till-s/kicad-usbadc-a7m195xx/README.md

# 130MSPS Dual-Channel Scope - Hardware Design

Please visit the [super-repository](https://github.com/till-s/ScOpen) for more information about this project.
