till-s/kicad-usbadc-a7m195xx/hw/usbadc.kicad_pcb

## KiCad design hw/usbadc.kicad_pcb (2026-05-31)

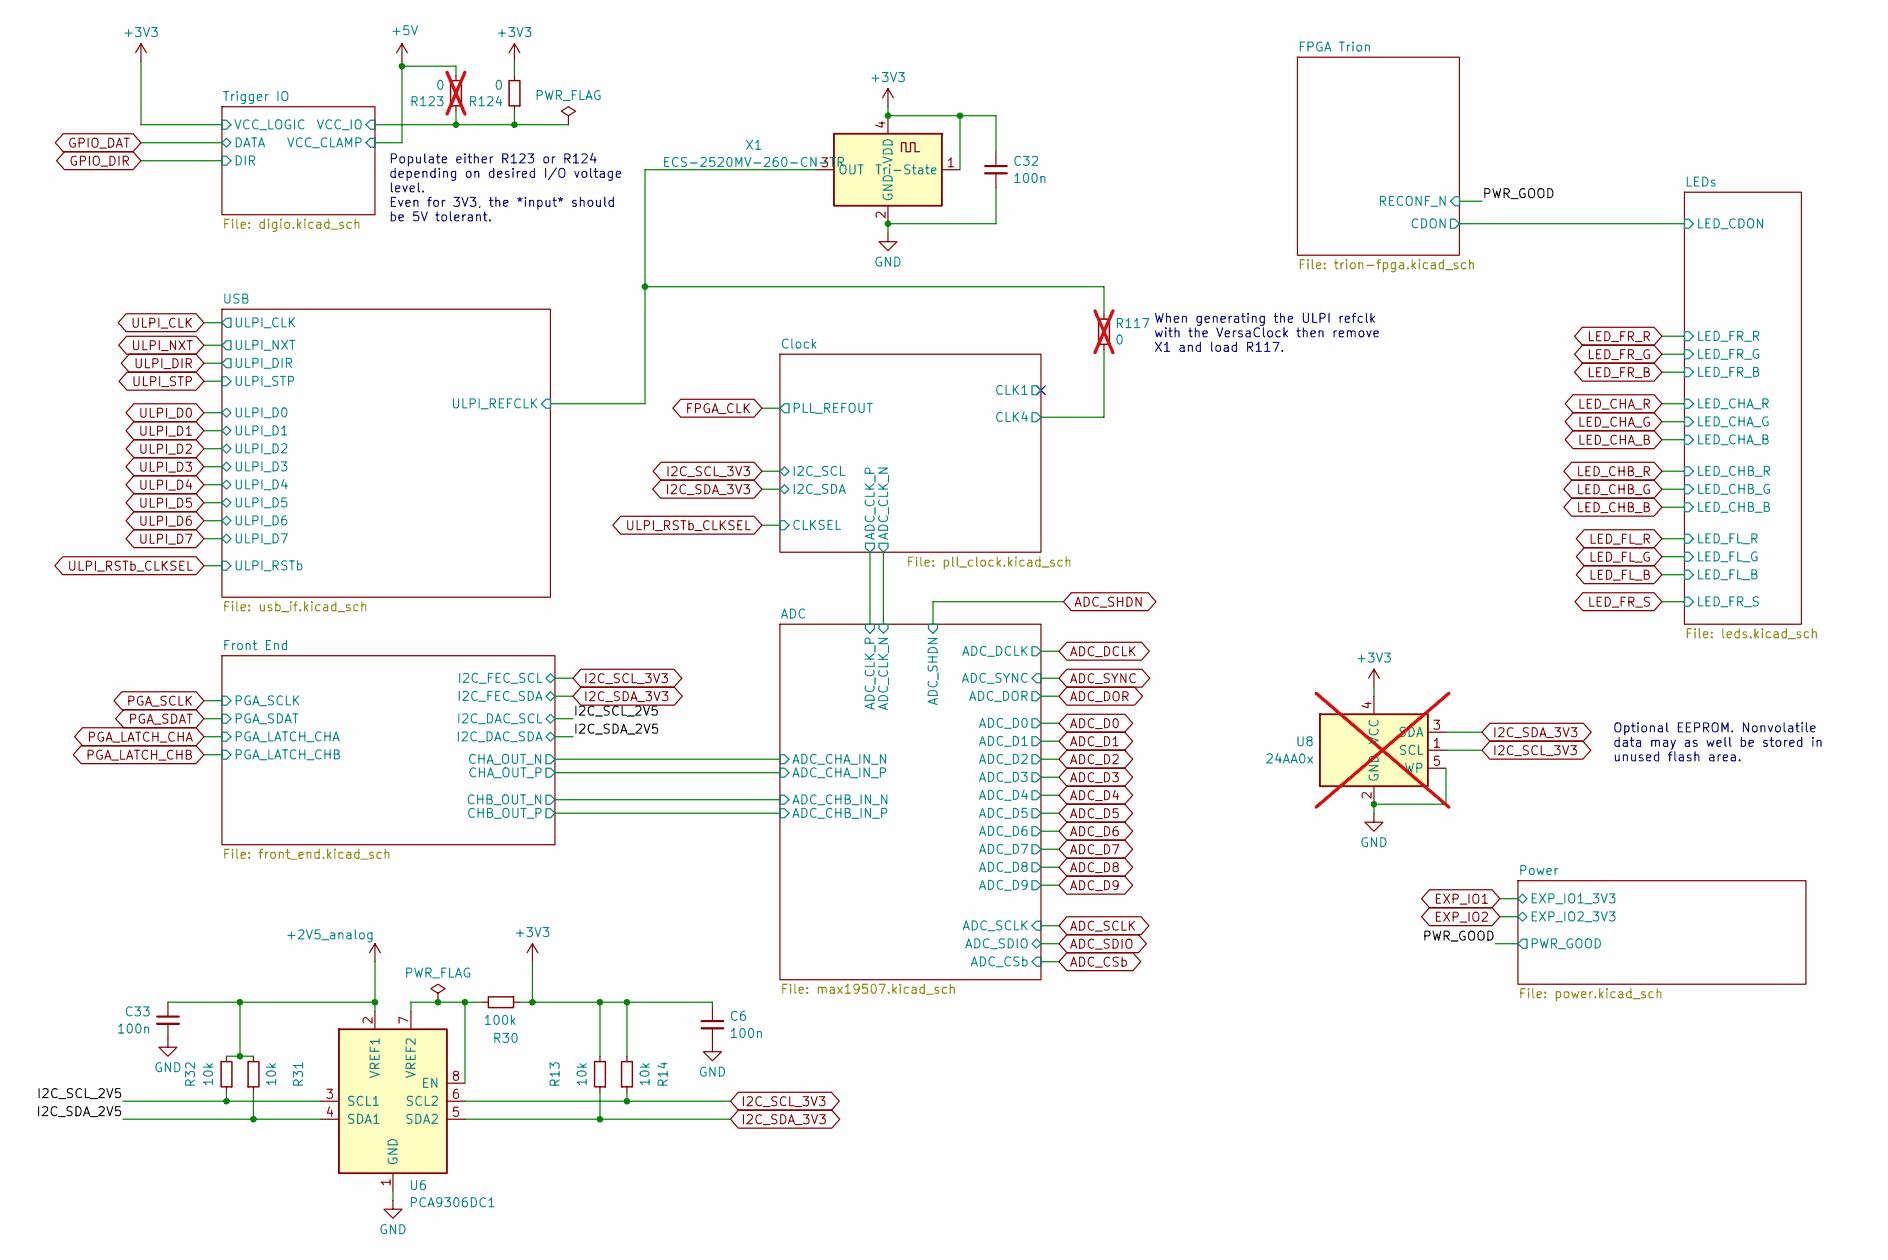
[picture p1: schematic usbadc.kicad_sch, 130MSPS Dual-Channel USB Scope]

Parts:
C6, C32, C33: 100n; C_0603_1608Metric; Part CL10B104KB8NFN
R13, R14, R31, R32: 10k; R_0603_1608Metric; Part RMCF0603FT10K0
R30: 100k; R_0603_1608Metric; Part RMCF0603FT100K
R117, R123: 0; R_0603_1608Metric; Part RMCF0603ZT0R00; not fitted
R124: 0; R_0603_1608Metric; Part RMCF0603ZT0R00
U6: PCA9306DC1; VSSOP-8_2.3x2mm_P0.5mm; Part PCA9306TDCURQ1
U8: 24AA0x; SOT-353_SC-70-5; Part 24AA01/LT; not fitted
X1: ECS-2520MV-260-CN-TR; Oscillator_SMD_ECS_2520MV-xxx-xx-4Pin_2.5x2.0mm; Part ECS-2520MV-260-CN-TR

Connections:
+2V5_analog: C33.1, R31.2, R32.2, U6.2 (VREF1); also elsewhere on the board
+3V3: C6.1, C32.1, R13.2, R14.2, R30.1, R124.2, U8.4 (VCC), X1.1 (Tri-State), X1.4 (VDD); also elsewhere on the board
+5V: R123.2; also elsewhere on the board
/Clock/CLK4: R117.2; also elsewhere on the board
/I2C_SCL_2V5: R32.1, U6.3 (SCL1); also elsewhere on the board
/I2C_SDA_2V5: R31.1, U6.4 (SDA1); also elsewhere on the board
/Trigger IO/VCC_IO: R123.1, R124.1; also elsewhere on the board
/USB/ULPI_REFCLK: R117.1, X1.3 (OUT); also elsewhere on the board
GND: C6.2, C32.2, C33.2, U6.1 (GND), U8.2 (GND), U8.5 (WP), X1.2 (GND); also elsewhere on the board
I2C_SCL_3V3: R14.1, U6.6 (SCL2), U8.1 (SCL); also elsewhere on the board
I2C_SDA_3V3: R13.1, U6.5 (SDA2), U8.3 (SDA); also elsewhere on the board
unnamed: R30.2, U6.7 (VREF2), U6.8 (EN)

Notes on the sheet:
Optional EEPROM. Nonvolatile data may as well be stored in unused flash area.
When generating the ULPI refclk with the VersaClock then remove X1 and load R117.
Populate either R123 or R124 depending on desired I/O voltage level. Even for 3V3, the *input* should be 5V tolerant.

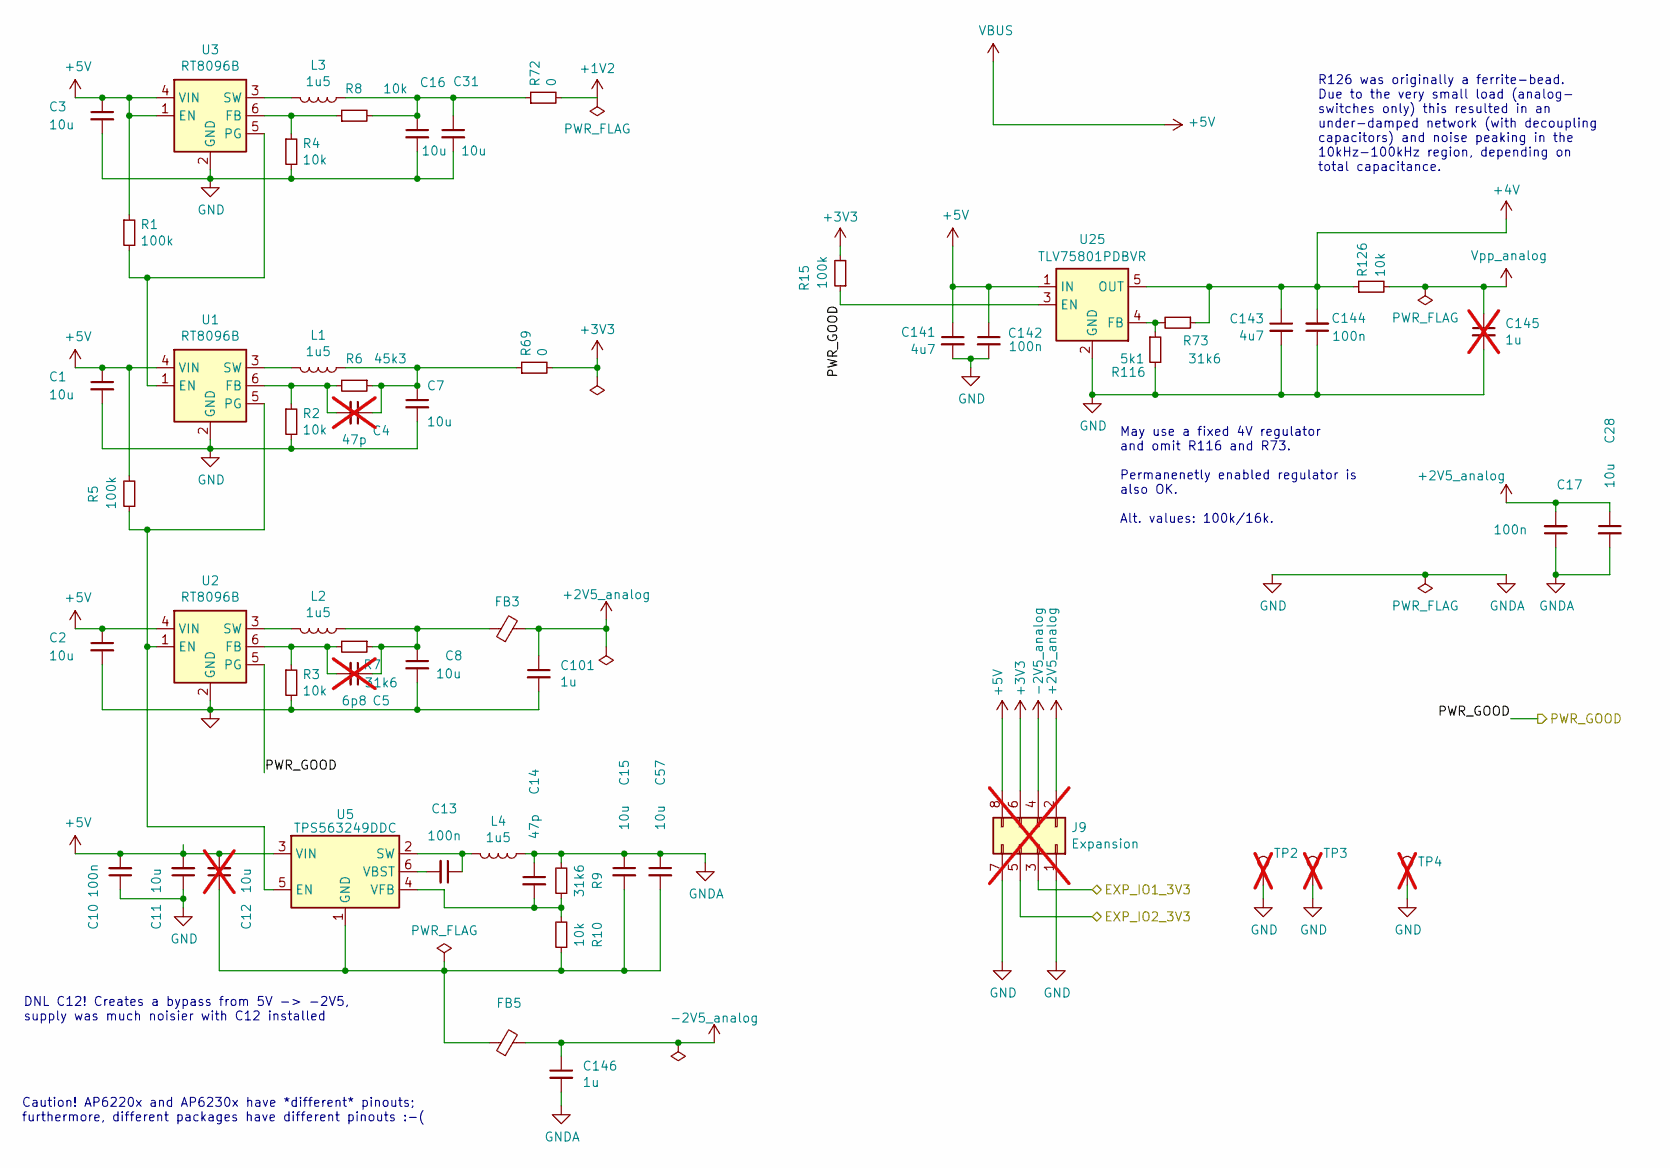
[picture p2: schematic power.kicad_sch, Power Supply and Expansion Connector]

Parts:
C1, C2, C3, C7, C8, C11, C15, C16, C28, C31, C57: 10u; C_1206_3216Metric; Part CL31A106KPHNNNE
C4: 47p; C_0603_1608Metric; Part 0603N470J101CT; not fitted
C5: 6p8; C_0603_1608Metric; Part 885012006050; not fitted
C10, C13, C17, C142, C144: 100n; C_0603_1608Metric; Part CL10B104KB8NFN
C12: 10u; C_1206_3216Metric; Part CL31A106KPHNNNE; not fitted
C14: 47p; C_0603_1608Metric; Part 0603N470J101CT
C101, C146: 1u; C_0805_2012Metric; Part CGA4J2X7R1C105K125AA
C141, C143: 4u7; C_0805_2012Metric; Part 2012X5R1C475K125AC
C145: 1u; C_0805_2012Metric; Part CGA4J2X7R1C105K125AA; not fitted
FB3, FB5: 600Ohm@100MHz; L_0603_1608Metric; Part MI0603J601R-10
J9: Expansion; PinHeader_2x04_P2.54mm_Vertical; not fitted
L1, L2, L3, L4: 1u5; L_1008_2520Metric; Part BDCD002520121R5MS1
R1, R5, R15: 100k; R_0603_1608Metric; Part RMCF0603FT100K
R2, R3, R4, R8, R10, R126: 10k; R_0603_1608Metric; Part RMCF0603FT10K0
R6: 45k3; R_0603_1608Metric; Part RMCF0603FT45K3
R7, R9, R73: 31k6; R_0603_1608Metric; Part RMCF0603FT31K6
R69, R72: 0; R_0603_1608Metric; Part RMCF0603ZT0R00
R116: 5k1; R_0603_1608Metric; Part RMCF0603FT5K10
TP2, TP3, TP4: TestPoint; PinHeader_1x01_P2.54mm_Vertical; not fitted
U1, U2, U3: RT8096B; SOT-23-6; Part RT8096BHGE
U5: TPS563249DDC; SOT-23-6; Part TPS563249DDCR
U25: TLV75801PDBVR; SOT-23-5; Part TLV75801PDBVR

Connections:
+1V2: R72.2; also elsewhere on the board
+2V5_analog: C17.2, C28.1, C101.1, FB3.2, J9.2; also elsewhere on the board
+3V3: J9.6, R15.2, R69.2; also elsewhere on the board
+4V: C143.1, C144.2, R73.1, R126.1, U25.5 (OUT); also elsewhere on the board
+5V: C1.1, C2.1, C3.1, C10.2, C11.2, C12.2, C141.1, C142.1, J9.8, R1.1, R5.2, U1.4 (VIN), U2.4 (VIN), U3.1 (EN), U3.4 (VIN), U5.3 (VIN), U25.1 (IN); also elsewhere on the board
-2V5_analog: C146.1, FB5.2, J9.4; also elsewhere on the board
/PWR_GOOD: R15.1, U2.5 (PG), U25.3 (EN); also elsewhere on the board
EXP_IO1: J9.3; also elsewhere on the board
EXP_IO2: J9.5; also elsewhere on the board
GND: C1.2, C2.2, C3.2, C7.2, C8.2, C10.1, C11.1, C14.1, C15.1, C16.2, C17.1, C28.2, C31.2, C57.1, C101.2, C141.2, C142.2, C143.2, C144.1, C145.2, C146.2, J9.1, J9.7, L4.1, R2.2, R3.2, R4.2, R9.2, R116.2, TP2.1, TP3.1, TP4.1, U1.2 (GND), U2.2 (GND), U3.2 (GND), U25.2 (GND); also elsewhere on the board
unnamed: C4.1, C7.1, L1.1, R6.1, R69.1
unnamed: C5.1, C8.1, FB3.1, L2.1, R7.1
unnamed: C16.1, C31.1, L3.1, R8.2, R72.1
unnamed: R1.2, U1.1 (EN), U3.5 (PG)
unnamed: C4.2, R2.1, R6.2, U1.6 (FB)
unnamed: R5.1, U1.5 (PG), U2.1 (EN), U5.5 (EN)
unnamed: L1.2, U1.3 (SW)
unnamed: C5.2, R3.1, R7.2, U2.6 (FB)
unnamed: L2.2, U2.3 (SW)
unnamed: R4.1, R8.1, U3.6 (FB)
unnamed: L3.2, U3.3 (SW)
unnamed: C12.1, C15.2, C57.2, FB5.1, R10.1, U5.1 (GND)
unnamed: C13.1, L4.2, U5.2 (SW)
unnamed: C13.2, U5.6 (VBST)
unnamed: C14.2, R9.1, R10.2, U5.4 (VFB)
unnamed: R73.2, R116.1, U25.4 (FB)
Vpp_analog: C145.1, R126.2; also elsewhere on the board

Notes on the sheet:
May use a fixed 4V regulator and omit R116 and R73. Permanenetly enabled regulator is also OK. Alt. values: 100k/16k.
R126 was originally a ferrite-bead. Due to the very small load (analog- switches only) this resulted in an under-damped network (with decoupling capacitors) and noise peaking in the 10kHz-100kHz region, depending on total capacitance.
DNL C12! Creates a bypass from 5V -> -2V5, supply was much noisier with C12 installed
Caution! AP6220x and AP6230x have *different* pinouts; furthermore, different packages have different pinouts :-(

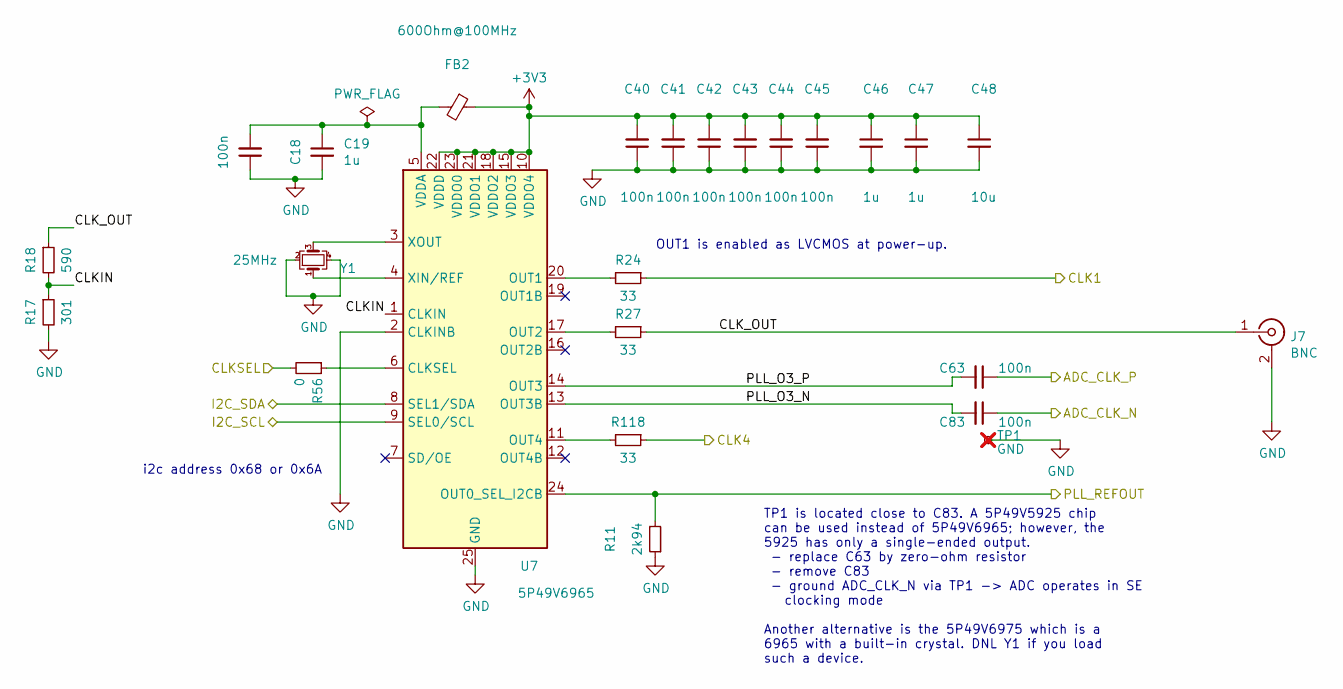
[picture p3: schematic pll_clock.kicad_sch, Clock Generator]

Parts:
C18, C40, C41, C42, C43, C44, C45, C63, C83: 100n; C_0603_1608Metric; Part CL10B104KB8NFN
C19, C46, C47: 1u; C_0805_2012Metric; Part CGA4J2X7R1C105K125AA
C48: 10u; C_1206_3216Metric; Part CL31A106KPHNNNE
FB2: 600Ohm@100MHz; L_0603_1608Metric; Part MI0603J601R-10
J7: BNC; BNC_Molex_0731713150; Part 0731713150
R11: 2k94; R_0603_1608Metric; Part RMCF0603FT2K94
R17: 301; R_0603_1608Metric; Part RMCF0603FT301R
R18: 590; R_0603_1608Metric; Part RMCF0603FT590R
R24, R27, R118: 33; R_0603_1608Metric; Part RMCF0603FT33R0
R56: 0; R_0603_1608Metric; Part RMCF0603ZT0R00
TP1: GND; single_pad; not fitted
U7: 5P49V6965; QFN-24-1EP_4x4mm_P0.5mm_EP2.8x2.8mm; Part 5P49V6965A000NLGI8
Y1: 25MHz; Crystal_SMD_Abracon_ABM10-4Pin_2.5x2.0mm; Part ABM10W-25.0000MHZ-8-B1U-T3

Connections:
+3V3: C40.2, C41.2, C42.2, C43.2, C44.2, C45.2, C46.1, C47.1, C48.1, FB2.1, U7.10 (VDDO4), U7.15 (VDDO3), U7.18 (VDDO2), U7.21 (VDDO1), U7.22 (VDDD), U7.23 (VDDO0); also elsewhere on the board
/ADC/ADC_CLK_N: C83.1; also elsewhere on the board
/ADC/ADC_CLK_P: C63.1; also elsewhere on the board
/Clock/CLK1: R24.1
/Clock/CLK4: R118.1; also elsewhere on the board
/Clock/CLKIN: R17.1, R18.2, U7.1 (CLKIN)
/Clock/CLK_OUT: J7.1 (In), R18.1, R27.1
/Clock/PLL_O3_N: C83.2, U7.13 (OUT3B)
/Clock/PLL_O3_P: C63.2, U7.14 (OUT3)
FPGA_CLK: R11.2, U7.24 (OUT0_SEL_I2CB); also elsewhere on the board
GND: C18.1, C19.2, C40.1, C41.1, C42.1, C43.1, C44.1, C45.1, C46.2, C47.2, C48.2, J7.2 (Ext), R11.1, R17.2, TP1.1, U7.2 (CLKINB), U7.25 (GND), Y1.2, Y1.4; also elsewhere on the board
I2C_SCL_3V3: U7.9 (SEL0/SCL); also elsewhere on the board
I2C_SDA_3V3: U7.8 (SEL1/SDA); also elsewhere on the board
unnamed: R56.1, U7.6 (CLKSEL)
unnamed: R24.2, U7.20 (OUT1)
unnamed: R27.2, U7.17 (OUT2)
unnamed: R118.2, U7.11 (OUT4)
unnamed: C18.2, C19.1, FB2.2, U7.5 (VDDA)
unnamed: U7.4 (XIN/REF), Y1.1
unnamed: U7.3 (XOUT), Y1.3
ULPI_RSTb_CLKSEL: R56.2; also elsewhere on the board

Notes on the sheet:
TP1 is located close to C83. A 5P49V5925 chip can be used instead of 5P49V6965; however, the 5925 has only a single-ended output. - replace C63 by zero-ohm resistor - remove C83 - ground ADC_CLK_N via TP1 -> ADC operates in SE clocking mode Another alternative is the 5P49V6975 which is a 6965 with 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
i2c address 0x68 or 0x6A
OUT1 is enabled as LVCMOS at power-up.

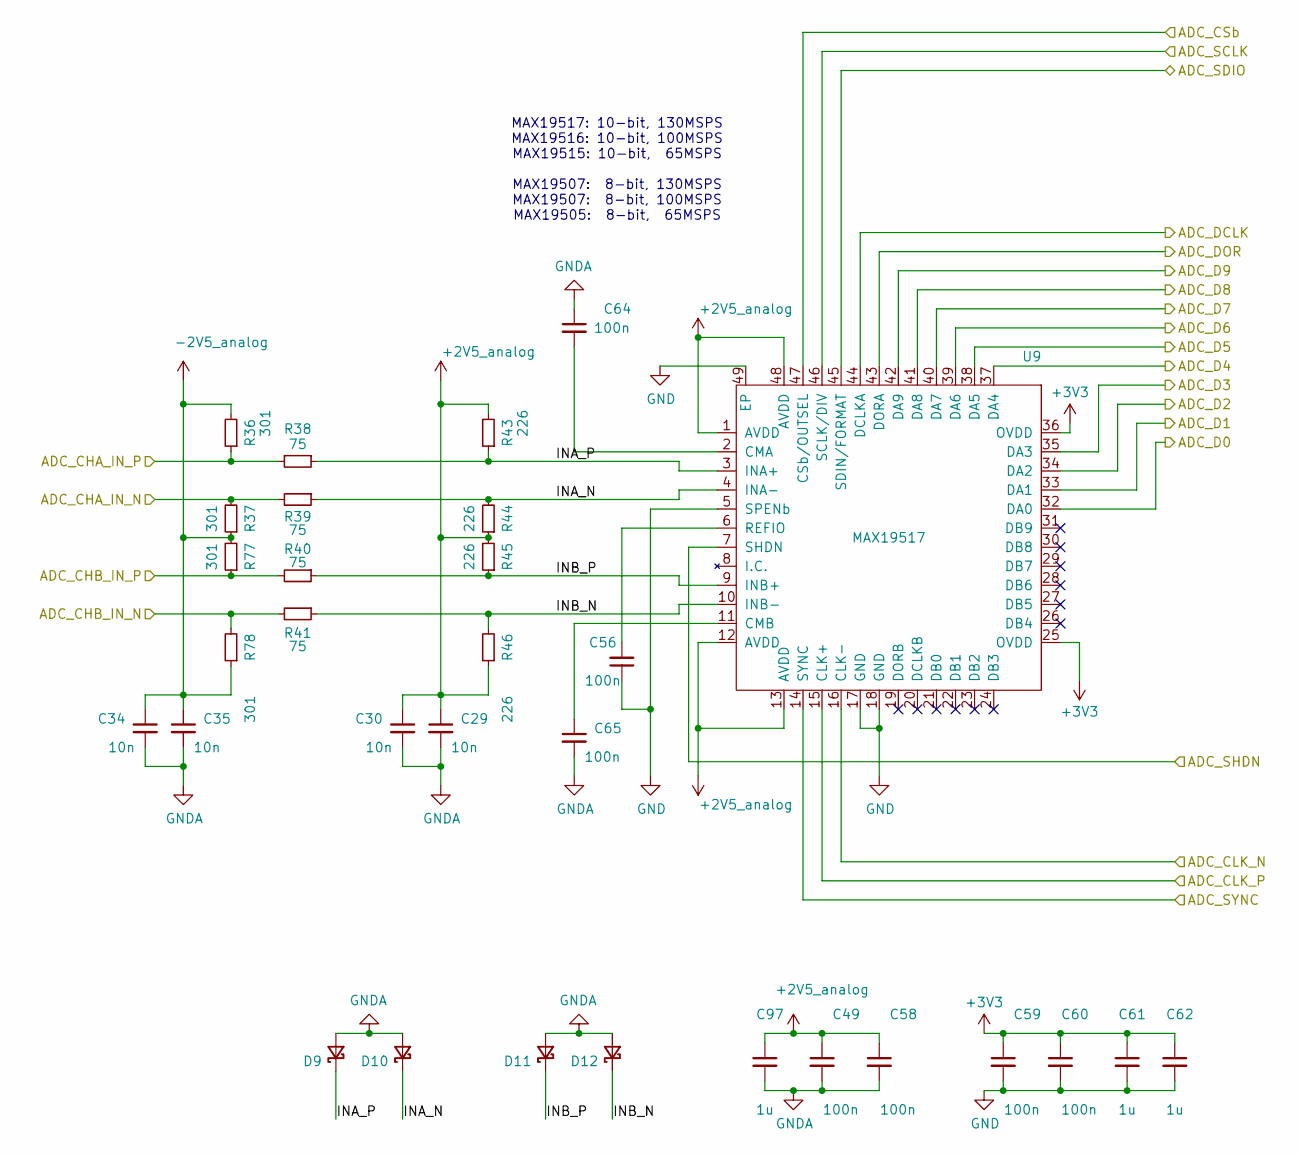
[picture p4: schematic max19507.kicad_sch, Dual-Channel ADC]

Parts:
C29, C30, C34, C35: 10n; C_0603_1608Metric; Part C0603C103J5RACTU
C49, C58, C59, C60: 100n; C_0402_1005Metric; Part C1005X7R1E104K050BB
C56, C64, C65: 100n; C_0603_1608Metric; Part CL10B104KB8NFN
C61, C62, C97: 1u; C_0805_2012Metric; Part CGA4J2X7R1C105K125AA
D9, D10, D11, D12: NSR0170HT1G; D_SOD-323; Part NSR0170HT1G
R36, R37, R77, R78: 301; R_0603_1608Metric; Part RMCF0603FT301R
R38, R39, R40, R41: 75; R_0603_1608Metric; Part RMCF0603FT75R0
R43, R44, R45, R46: 226; R_0603_1608Metric; Part RMCF0603FT226R
U9: MAX19517; QFN-48-1EP_7x7mm_P0.5mm_EP5.6x5.6mm_ThermalVias_biggerholes; Part MAX19517ETM+

Connections:
+2V5_analog: C29.1, C30.1, C49.1, C58.1, C97.1, R43.2, R44.1, R45.2, R46.1, U9.1 (AVDD), U9.12 (AVDD), U9.13 (AVDD), U9.48 (AVDD); also elsewhere on the board
+3V3: C59.1, C60.1, C61.1, C62.1, U9.25 (OVDD), U9.36 (OVDD); also elsewhere on the board
-2V5_analog: C34.1, C35.1, R36.2, R37.1, R77.2, R78.1; also elsewhere on the board
/ADC/ADC_CHA_IN_N: R37.2, R39.2; also elsewhere on the board
/ADC/ADC_CHA_IN_P: R36.1, R38.2; also elsewhere on the board
/ADC/ADC_CHB_IN_N: R41.2, R78.2; also elsewhere on the board
/ADC/ADC_CHB_IN_P: R40.2, R77.1; also elsewhere on the board
/ADC/ADC_CLK_N: U9.16 (CLK-); also elsewhere on the board
/ADC/ADC_CLK_P: U9.15 (CLK+); also elsewhere on the board
/ADC/INA_N: D10.1 (K), R39.1, R44.2, U9.4 (INA-)
/ADC/INA_P: D9.1 (K), R38.1, R43.1, U9.3 (INA+)
/ADC/INB_N: D12.1 (K), R41.1, R46.2, U9.10 (INB-)
/ADC/INB_P: D11.1 (K), R40.1, R45.1, U9.9 (INB+)
ADC_CSb: U9.47 (CSb/OUTSEL); also elsewhere on the board
ADC_D0: U9.32 (DA0); also elsewhere on the board
ADC_D1: U9.33 (DA1); also elsewhere on the board
ADC_D2: U9.34 (DA2); also elsewhere on the board
ADC_D3: U9.35 (DA3); also elsewhere on the board
ADC_D4: U9.37 (DA4); also elsewhere on the board
ADC_D5: U9.38 (DA5); also elsewhere on the board
ADC_D6: U9.39 (DA6); also elsewhere on the board
ADC_D7: U9.40 (DA7); also elsewhere on the board
ADC_D8: U9.41 (DA8); also elsewhere on the board
ADC_D9: U9.42 (DA9); also elsewhere on the board
ADC_DCLK: U9.44 (DCLKA); also elsewhere on the board
ADC_DOR: U9.43 (DORA); also elsewhere on the board
ADC_SCLK: U9.46 (SCLK/DIV); also elsewhere on the board
ADC_SDIO: U9.45 (SDIN/FORMAT); also elsewhere on the board
ADC_SHDN: U9.7 (SHDN); also elsewhere on the board
ADC_SYNC: U9.14 (SYNC); also elsewhere on the board
GND: C29.2, C30.2, C34.2, C35.2, C49.2, C56.1, C58.2, C59.2, C60.2, C61.2, C62.2, C64.1, C65.2, C97.2, D9.2 (A), D10.2 (A), D11.2 (A), D12.2 (A), U9.5 (SPENb), U9.17 (GND), U9.18 (GND), U9.49 (EP); also elsewhere on the board
unnamed: C64.2, U9.2 (CMA)
unnamed: C65.1, U9.11 (CMB)
unnamed: C56.2, U9.6 (REFIO)

Notes on the sheet:
MAX19517: 10-bit, 130MSPS MAX19516: 10-bit, 100MSPS MAX19515: 10-bit, 65MSPS MAX19507: 8-bit, 130MSPS MAX19507: 8-bit, 100MSPS MAX19505: 8-bit, 65MSPS

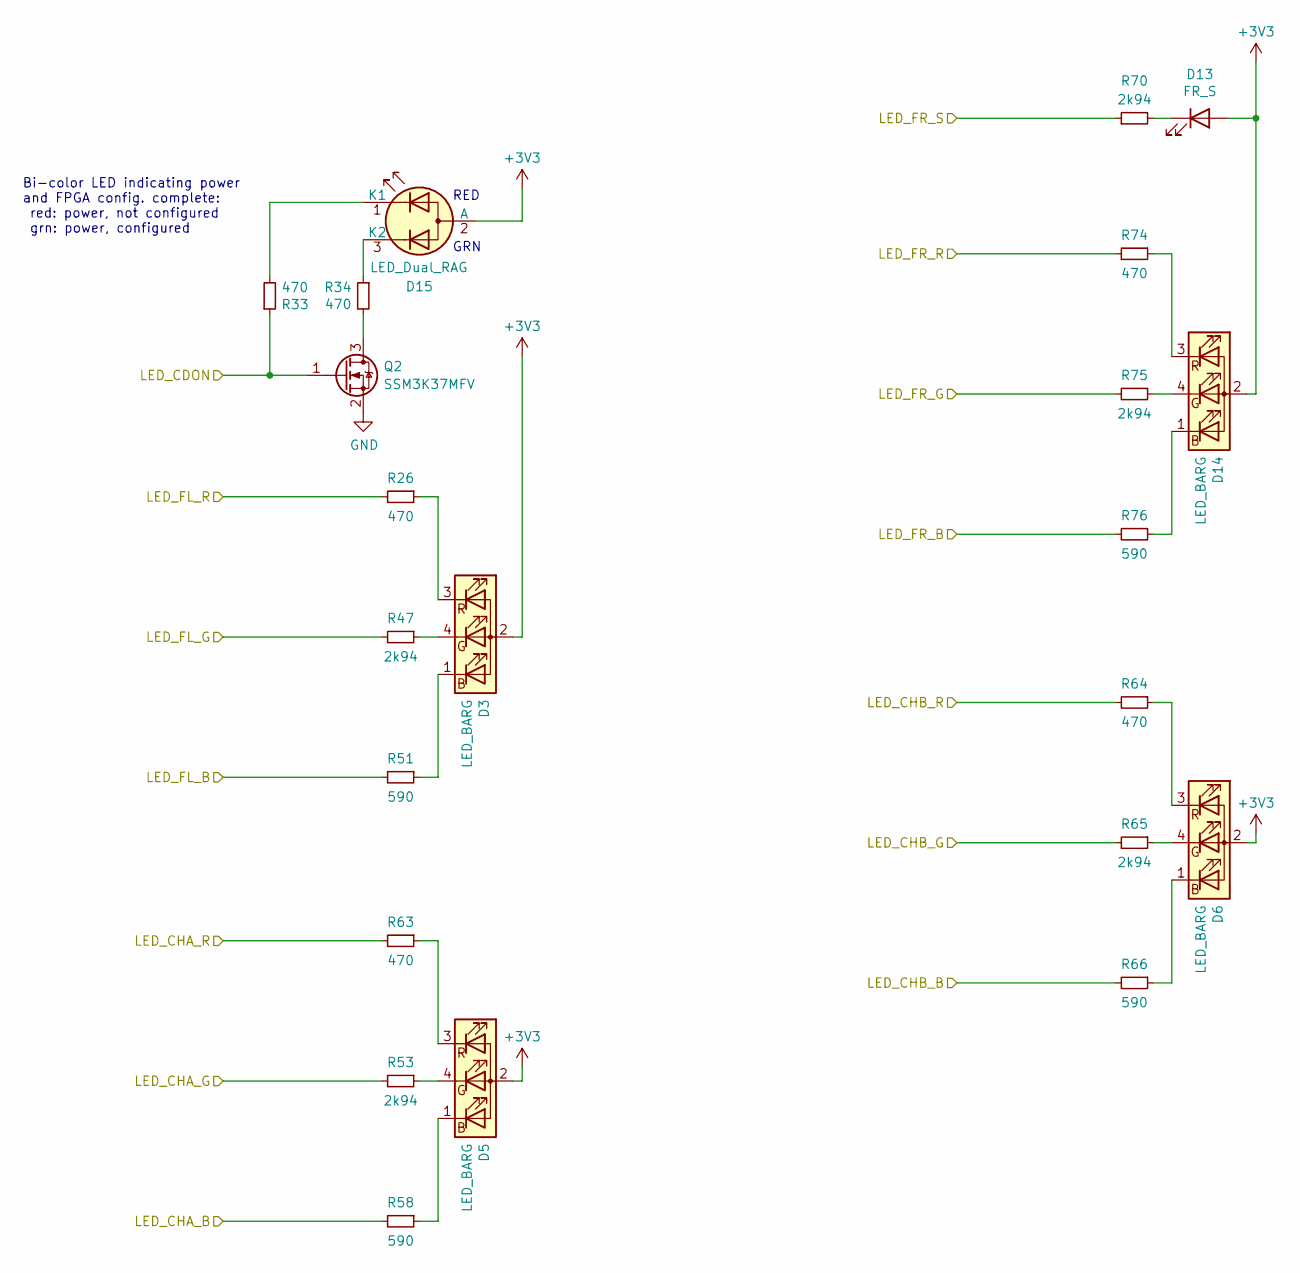
[picture p5: schematic leds.kicad_sch]

Parts:
D3, D5, D6, D14: LED_BARG; LED_RGB_2504_horiz_barg; Part APFA2507QBDSEEZGKC
D13: FR_S; LED_0603_1608Metric_reduced_cyrd; Part 155060GS75300
D15: LED_Dual_RAG; LED_Wuerth_Sideview; Part 155124RV73200
Q2: SSM3K37MFV; SOT-723; Part SSM3K37MFV
R26, R33, R34, R63, R64, R74: 470; R_0603_1608Metric; Part RMCF0603FT470R
R47, R53, R65, R75: 2k94; R_0603_1608Metric; Part RMCF0603FT2K94
R51, R58, R66, R76: 590; R_0603_1608Metric; Part RMCF0603FT590R
R70: 2k94; R_0603_1608Metric; Part RMCF0603FT470R

Connections:
+3V3: D3.2 (A), D5.2 (A), D6.2 (A), D13.2 (A), D14.2 (A), D15.2 (A); also elsewhere on the board
/FPGA Trion/CDON: Q2.1 (G), R33.1; also elsewhere on the board
GND: Q2.2 (S); also elsewhere on the board
LED_CHA_B: R58.2; also elsewhere on the board
LED_CHA_G: R53.2; also elsewhere on the board
LED_CHA_R: R63.2; also elsewhere on the board
LED_CHB_B: R66.2; also elsewhere on the board
LED_CHB_G: R65.2; also elsewhere on the board
LED_CHB_R: R64.2; also elsewhere on the board
LED_FL_B: R51.2; also elsewhere on the board
LED_FL_G: R47.2; also elsewhere on the board
LED_FL_R: R26.2; also elsewhere on the board
LED_FR_B: R76.2; also elsewhere on the board
LED_FR_G: R75.2; also elsewhere on the board
LED_FR_R: R74.2; also elsewhere on the board
LED_FR_S: R70.1; also elsewhere on the board
unnamed: D3.1 (BK), R51.1
unnamed: D3.4 (GK), R47.1
unnamed: D3.3 (RK), R26.1
unnamed: D5.1 (BK), R58.1
unnamed: D5.4 (GK), R53.1
unnamed: D5.3 (RK), R63.1
unnamed: D6.1 (BK), R66.1
unnamed: D6.4 (GK), R65.1
unnamed: D6.3 (RK), R64.1
unnamed: D13.1 (K), R70.2
unnamed: D14.1 (BK), R76.1
unnamed: D14.4 (GK), R75.1
unnamed: D14.3 (RK), R74.1
unnamed: D15.1 (K1), R33.2
unnamed: D15.3 (K2), R34.1
unnamed: Q2.3 (D), R34.2

Notes on the sheet:
RED
GRN
Bi-color LED indicating power and FPGA config. complete: red: power, not configured grn: power, configured

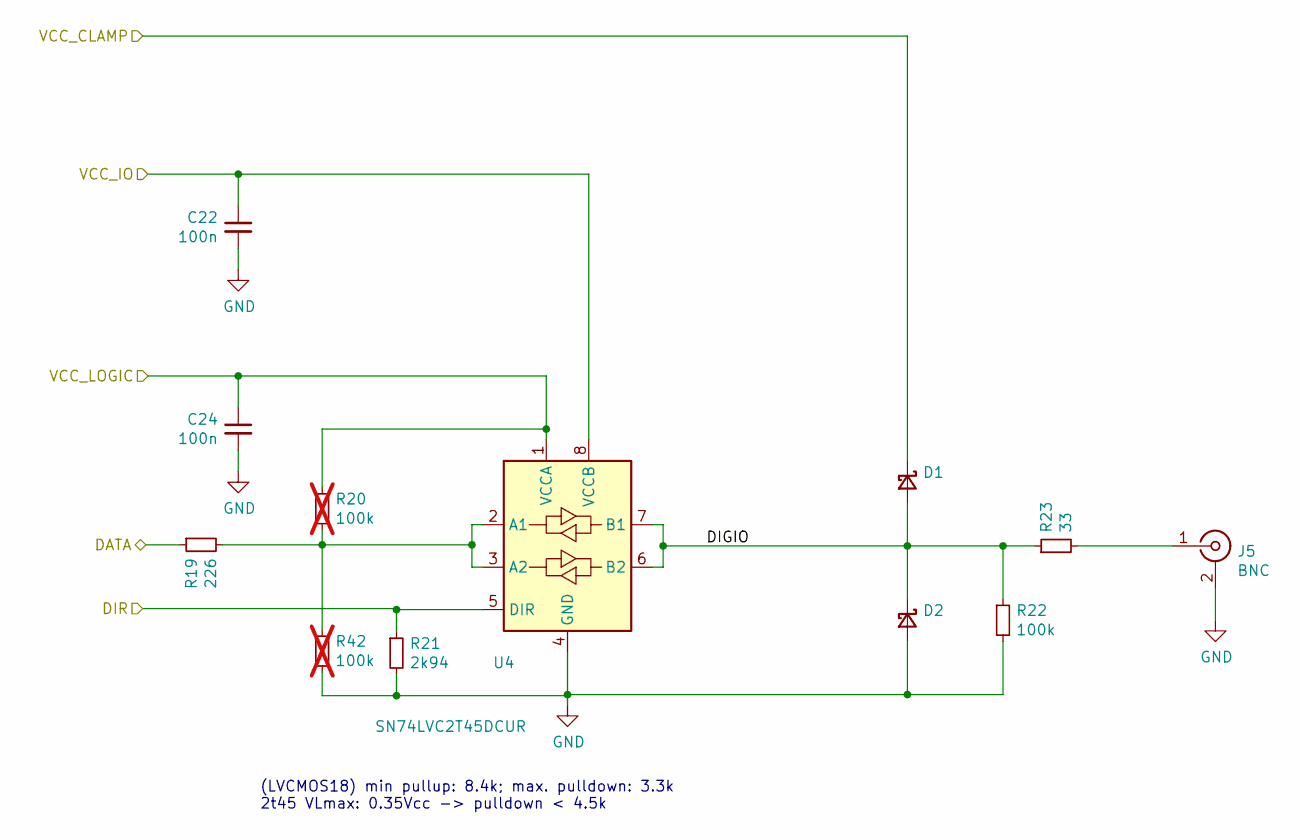
[picture p6: schematic digio.kicad_sch, GPIO (External Trigger In/Out)]

Parts:
C22, C24: 100n; C_0603_1608Metric; Part CL10B104KB8NFN
D1, D2: NSR0170HT1G; D_SOD-323; Part NSR0170HT1G
J5: BNC; BNC_Molex_0731713150; Part 0731713150
R19: 226; R_0603_1608Metric; Part RMCF0603FT226R
R20, R42: 100k; R_0603_1608Metric; Part RMCF0603FT100K; not fitted
R21: 2k94; R_0603_1608Metric; Part RMCF0603FT2K94
R22: 100k; R_0603_1608Metric; Part RMCF0603FT100K
R23: 33; R_0603_1608Metric; Part RMCF0603FT33R0
U4: SN74LVC2T45DCUR; VSSOP-8_2.3x2mm_P0.5mm; Part 74LVC2T45DC,125

Connections:
+3V3: C24.1, R20.1, U4.1 (VCCA); also elsewhere on the board
+5V: D1.1 (K); also elsewhere on the board
/Trigger IO/DIGIO: D1.2 (A), D2.1 (K), R22.1, R23.1, U4.6 (B2), U4.7 (B1)
/Trigger IO/VCC_IO: C22.1, U4.8 (VCCB); also elsewhere on the board
GND: C22.2, C24.2, D2.2 (A), J5.2 (Ext), R21.2, R22.2, R42.2, U4.4 (GND); also elsewhere on the board
GPIO_DAT: R19.1; also elsewhere on the board
GPIO_DIR: R21.1, U4.5 (DIR); also elsewhere on the board
unnamed: J5.1 (In), R23.2
unnamed: R19.2, R20.2, R42.1, U4.2 (A1), U4.3 (A2)

Notes on the sheet:
(LVCMOS18) min pullup: 8.4k; max. pulldown: 3.3k 2t45 VLmax: 0.35Vcc -> pulldown < 4.5k

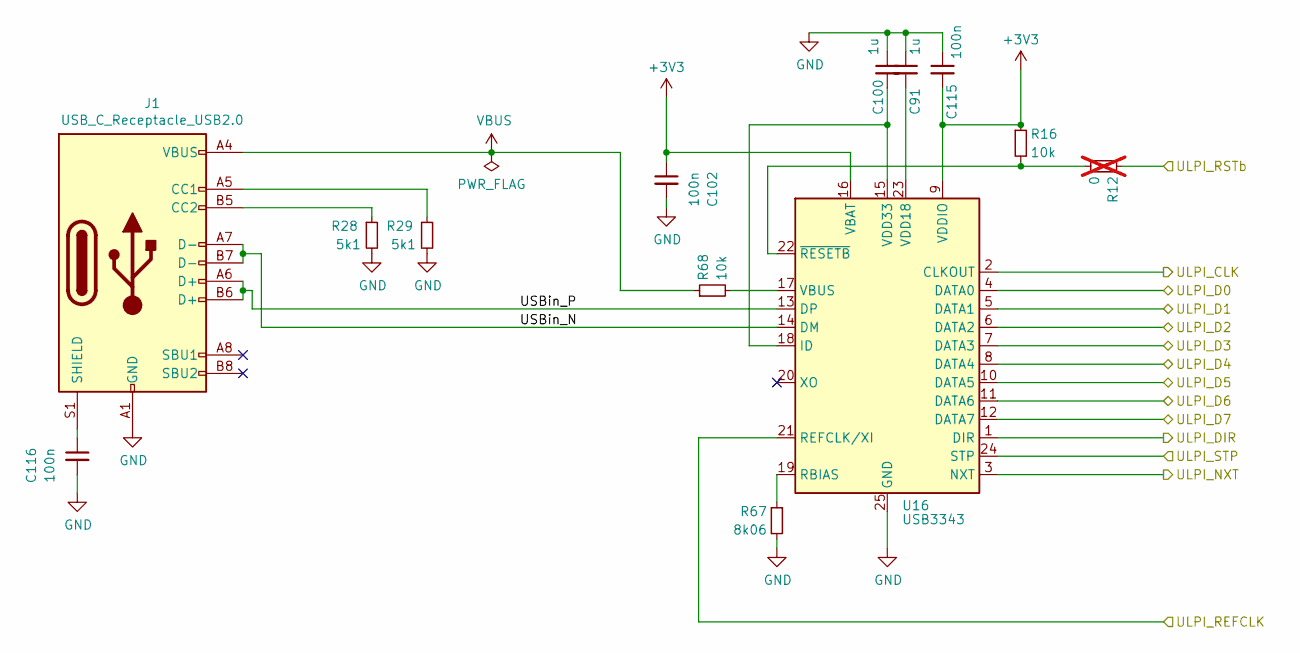
[picture p7: schematic usb_if.kicad_sch, USB Phy]

Parts:
C91, C100: 1u; C_0603_1608Metric; Part CL10B104KB8NFNC
C102, C115, C116: 100n; C_0603_1608Metric; Part CL10B104KB8NFN
J1: USB_C_Receptacle_USB2.0; USB_C_Receptacle_Molex_2171790001_16P_TopMnt_Horizontal; Part 2171790001
R12: 0; R_0603_1608Metric; Part RMCF0603ZT0R00; not fitted
R16, R68: 10k; R_0603_1608Metric; Part RMCF0603FT10K0
R28, R29: 5k1; R_0603_1608Metric; Part RMCF0603FT5K10
R67: 8k06; R_0603_1608Metric; Part RMCF0603FT8K06
U16: USB3343; QFN-24-1EP_4x4mm_P0.5mm_EP2.6x2.6mm; Part USB3343-CP-TR

Connections:
+3V3: C102.1, C115.2, R16.1, U16.9 (VDDIO), U16.16 (VBAT); also elsewhere on the board
+5V: J1.A4 (VBUS), J1.A9 (VBUS), J1.B4 (VBUS), J1.B9 (VBUS), R68.1; also elsewhere on the board
/USB/ULPI_REFCLK: U16.21 (REFCLK/XI); also elsewhere on the board
/USB/USBin_N: J1.A7 (D-), J1.B7 (D-), U16.14 (DM)
/USB/USBin_P: J1.A6 (D+), J1.B6 (D+), U16.13 (DP)
GND: C91.1, C100.1, C102.2, C115.1, C116.2, J1.A1 (GND), J1.A12 (GND), J1.B1 (GND), J1.B12 (GND), R28.2, R29.2, R67.2, U16.25 (GND); also elsewhere on the board
unnamed: J1.A5 (CC1), R29.1
unnamed: J1.B5 (CC2), R28.1
unnamed: C116.1, J1.S1 (SHIELD)
unnamed: C100.2, U16.15 (VDD33), U16.18 (ID)
unnamed: R67.1, U16.19 (RBIAS)
unnamed: R68.2, U16.17 (VBUS)
unnamed: C91.2, U16.23 (VDD18)
unnamed: R12.2, R16.2, U16.22 (~RESETB)
ULPI_CLK: U16.2 (CLKOUT); also elsewhere on the board
ULPI_D0: U16.4 (DATA0); also elsewhere on the board
ULPI_D1: U16.5 (DATA1); also elsewhere on the board
ULPI_D2: U16.6 (DATA2); also elsewhere on the board
ULPI_D3: U16.7 (DATA3); also elsewhere on the board
ULPI_D4: U16.8 (DATA4); also elsewhere on the board
ULPI_D5: U16.10 (DATA5); also elsewhere on the board
ULPI_D6: U16.11 (DATA6); also elsewhere on the board
ULPI_D7: U16.12 (DATA7); also elsewhere on the board
ULPI_DIR: U16.1 (DIR); also elsewhere on the board
ULPI_NXT: U16.3 (NXT); also elsewhere on the board
ULPI_RSTb_CLKSEL: R12.1; also elsewhere on the board
ULPI_STP: U16.24 (STP); also elsewhere on the board

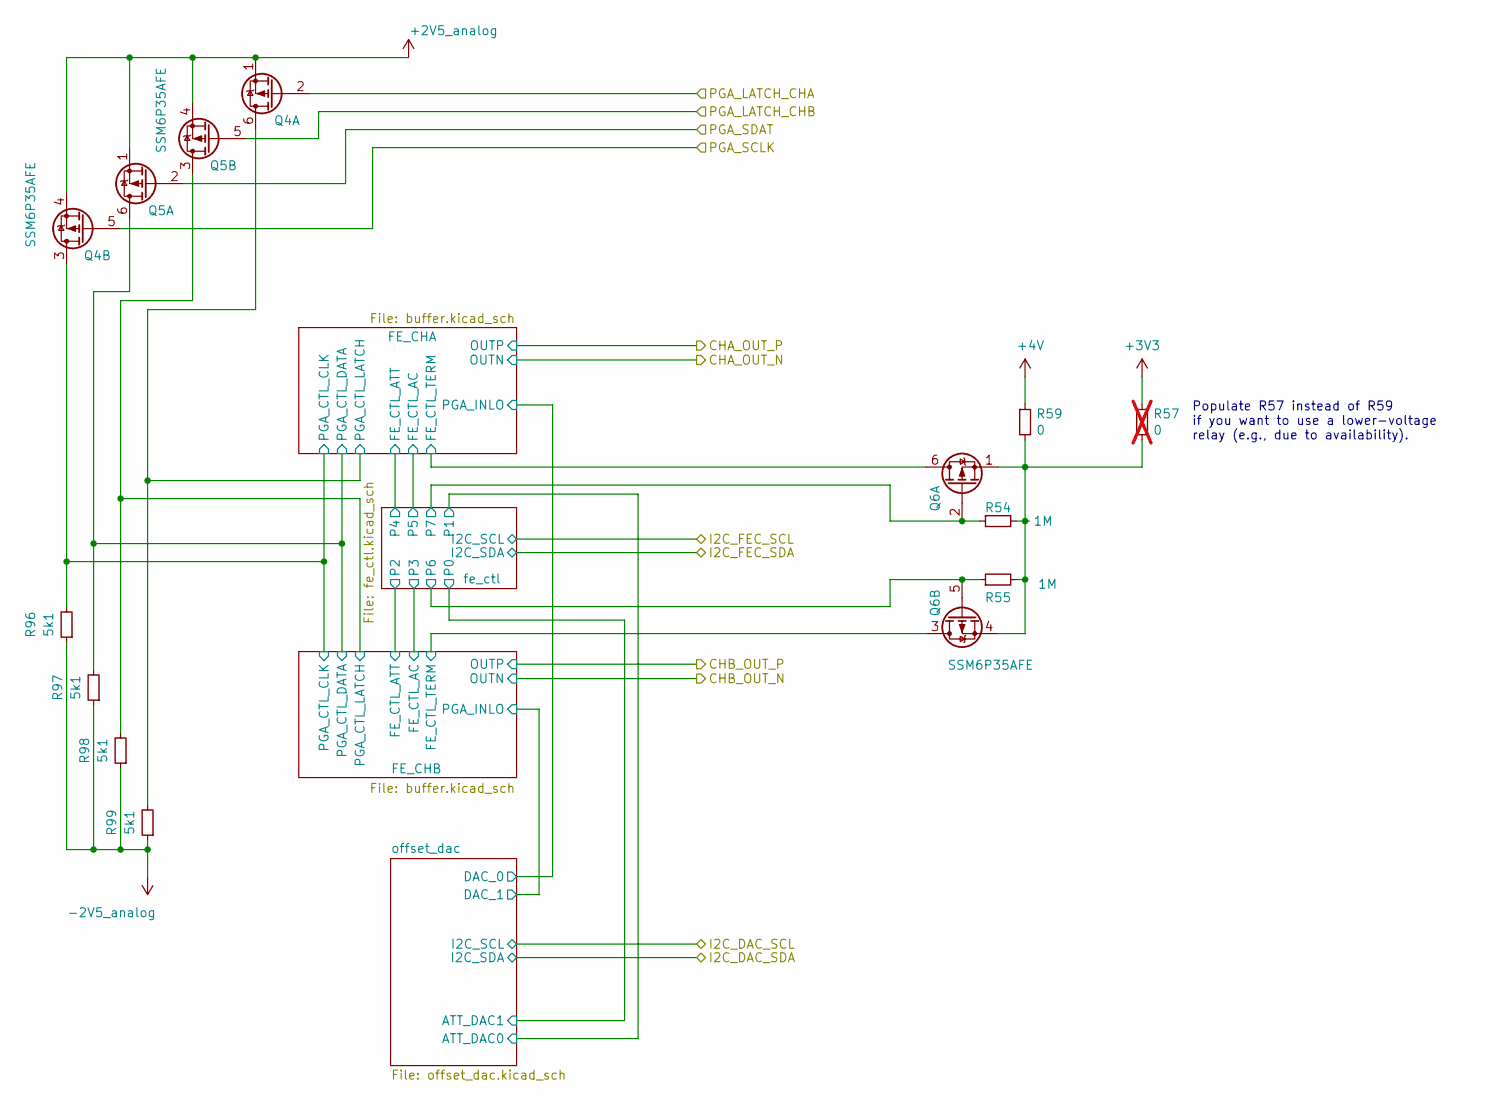
[picture p8: schematic front_end.kicad_sch, Front End]

Parts:
Q4, Q5, Q6: SSM6P35AFE; SOT-563-adjusted; Part SSM6P35AFE
R54, R55: 1M; R_0603_1608Metric; Part RMCF0603FT1M00
R57: 0; R_0603_1608Metric; Part RMCF0603ZT0R00; not fitted
R59: 0; R_0603_1608Metric; Part RMCF0603ZT0R00
R96, R97, R98, R99: 5k1; R_0603_1608Metric; Part RMCF0603FT5K10

Connections:
+2V5_analog: Q4.1 (S), Q4.4 (S), Q5.1 (S), Q5.4 (S); also elsewhere on the board
+3V3: R57.1; also elsewhere on the board
+4V: R59.1; also elsewhere on the board
-2V5_analog: R96.1, R97.1, R98.1, R99.1; also elsewhere on the board
/Front End/FE_CHA/FE_CTL_TERM: Q6.6 (D); also elsewhere on the board
/Front End/FE_CHA/PGA_CTL_CLK: Q4.3 (D), R96.2; also elsewhere on the board
/Front End/FE_CHA/PGA_CTL_DATA: Q5.6 (D), R97.2; also elsewhere on the board
/Front End/FE_CHA/PGA_CTL_LATCH: Q4.6 (D), R99.2; also elsewhere on the board
/Front End/FE_CHB/FE_CTL_TERM: Q6.3 (D); also elsewhere on the board
/Front End/FE_CHB/PGA_CTL_LATCH: Q5.3 (D), R98.2; also elsewhere on the board
/Front End/fe_ctl/P6: Q6.5 (G), R55.1; also elsewhere on the board
/Front End/fe_ctl/P7: Q6.2 (G), R54.1; also elsewhere on the board
unnamed: Q6.1 (S), Q6.4 (S), R54.2, R55.2, R57.2, R59.2
PGA_LATCH_CHA: Q4.2 (G); also elsewhere on the board
PGA_LATCH_CHB: Q5.5 (G); also elsewhere on the board
PGA_SCLK: Q4.5 (G); also elsewhere on the board
PGA_SDAT: Q5.2 (G); also elsewhere on the board

Notes on the sheet:
Populate R57 instead of R59 if you want to use a lower-voltage relay (e.g., due to availability).
