till-s/kicad-usbadc-a7m195xx/hw/usbadc.kicad_pcb

## KiCad design hw/usbadc.kicad_pcb (continued)

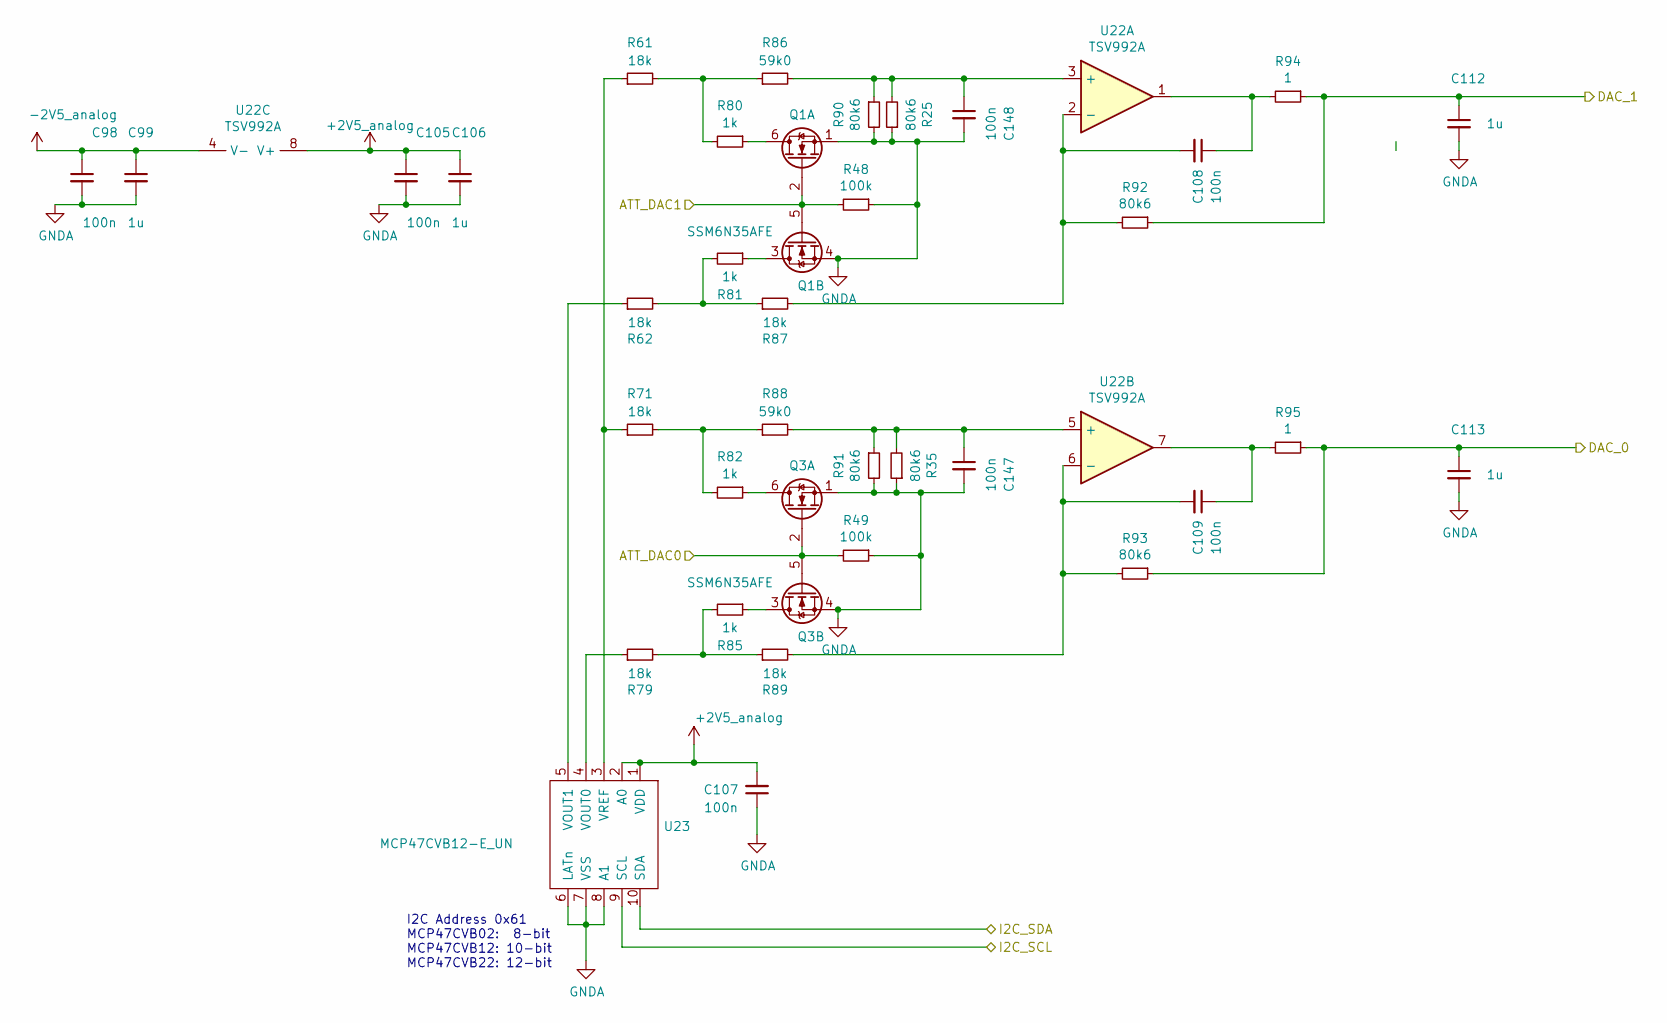
[picture p9: schematic offset_dac.kicad_sch, Calibration DAC]

Parts:
C98, C105, C107, C108, C109, C147, C148: 100n; C_0603_1608Metric; Part CL10B104KB8NFN
C99, C106, C112, C113: 1u; C_0805_2012Metric; Part CGA4J2X7R1C105K125AA
Q1, Q3: SSM6N35AFE; SOT-563-adjusted; Part SSM6N35AFE
R25, R35, R90, R91, R92, R93: 80k6; R_0603_1608Metric; Part RMCF0603FT80K6
R48, R49: 100k; R_0603_1608Metric; Part RMCF0603FT100K
R61, R62, R71, R79, R87, R89: 18k; R_0603_1608Metric; Part RMCF0603FT18K0
R80, R81, R82, R85: 1k; R_0603_1608Metric; Part RMCF0603FT1K00
R86, R88: 59k0; R_0603_1608Metric; Part RMCF0603FT59K0
R94, R95: 1; R_0603_1608Metric; Part RMCF0603FT1R00
U22: TSV992A; DFN-8-1EP_2x2mm_P0.5mm_EP0.45x1.6mm; Part TSV992IQ2
U23: MCP47CVB12-E_UN; MSOP-10_3x3mm_P0.5mm; Part MCP47CVB12-E/UN

Connections:
+2V5_analog: C105.1, C106.1, C107.2, U22.8 (V+), U23.1 (VDD), U23.2 (A0); also elsewhere on the board
-2V5_analog: C98.1, C99.1, U22.4 (V-); also elsewhere on the board
/Front End/FE_CHA/PGA_INLO: C113.1, R93.1, R95.1; also elsewhere on the board
/Front End/FE_CHB/PGA_INLO: C112.1, R92.1, R94.1; also elsewhere on the board
/Front End/fe_ctl/P0: Q1.2 (G), Q1.5 (G), R48.2; also elsewhere on the board
/Front End/fe_ctl/P1: Q3.2 (G), Q3.5 (G), R49.2; also elsewhere on the board
/I2C_SCL_2V5: U23.9 (SCL); also elsewhere on the board
/I2C_SDA_2V5: U23.10 (SDA); also elsewhere on the board
GND: C98.2, C99.2, C105.2, C106.2, C107.1, C112.2, C113.2, C147.2, C148.2, Q1.1 (S), Q1.4 (S), Q3.1 (S), Q3.4 (S), R25.1, R35.1, R48.1, R49.1, R90.2, R91.2, U23.6 (LATn), U23.7 (VSS), U23.8 (A1); also elsewhere on the board
unnamed: C108.1, R94.2, U22.1
unnamed: C109.1, R95.2, U22.7
unnamed: Q1.6 (D), R80.1
unnamed: Q1.3 (D), R81.1
unnamed: Q3.6 (D), R82.1
unnamed: Q3.3 (D), R85.1
unnamed: R61.2, R80.2, R86.1
unnamed: R62.2, R81.2, R87.1
unnamed: R71.2, R82.2, R88.1
unnamed: R79.2, R85.2, R89.1
unnamed: C148.1, R25.2, R86.2, R90.1, U22.3 (+)
unnamed: C108.2, R87.2, R92.2, U22.2 (-)
unnamed: C147.1, R35.2, R88.2, R91.1, U22.5 (+)
unnamed: C109.2, R89.2, R93.2, U22.6 (-)
unnamed: R79.1, U23.4 (VOUT0)
unnamed: R62.1, U23.5 (VOUT1)
unnamed: R61.1, R71.1, U23.3 (VREF)

Notes on the sheet:
I2C Address 0x61 MCP47CVB02: 8-bit MCP47CVB12: 10-bit MCP47CVB22: 12-bit

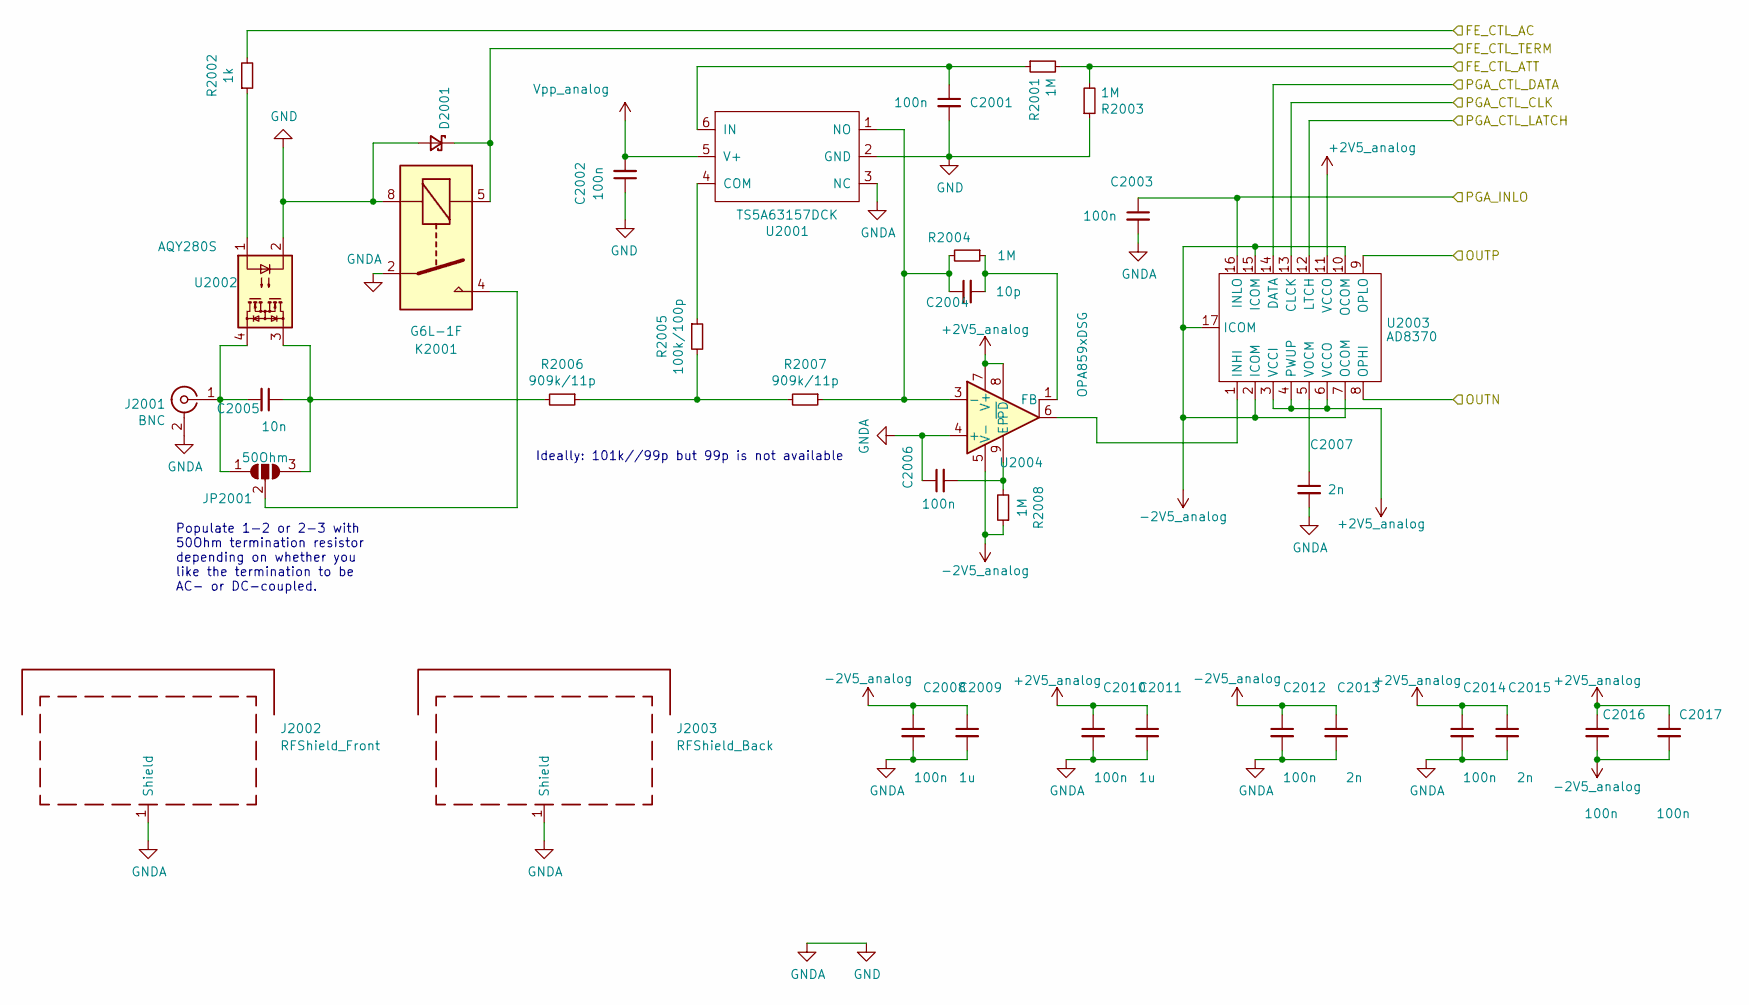
[picture p10: schematic buffer.kicad_sch]

Parts:
C2001, C2002, C2003, C2006, C2008, C2010, C2012, C2014, C2016, C2017: 100n; C_0603_1608Metric; Part CL10B104KB8NFN
C2004: 10p; C_0402_1005Metric
C2005: 10n; C_0805_2012Metric
C2007, C2013, C2015: 2n; C_0603_1608Metric
C2009, C2011: 1u; C_0805_2012Metric; Part CGA4J2X7R1C105K125AA
D2001: NSR0170HT1G; D_SOD-323; Part NSR0170HT1G
J2001: BNC; BNC_Molex_0731713150; Part 0731713150
J2002: RFShield_Front; Leader SMS-255F; Part SMS-255F+C
J2003: RFShield_Back; SMS-202F; Part SMS-202F+C
JP2001: 50Ohm; J_0603_V
K2001: G6L-1F; Part G6L-1F
R2001, R2003, R2008: 1M; R_0603_1608Metric
R2002: 1k; R_0603_1608Metric
R2004: 1M; R_0402_1005Metric
R2005: 100k/100p; RC_0603_1608Metric
R2006, R2007: 909k/11p; RC_0603_1608Metric
U2001: TS5A63157DCK; SOT-363_SC-70-6_small_cyd
U2002: AQY280S; SOP-4_3.8x4.1mm_P2.54mm
U2003: AD8370; TSSOP-16-1EP_4.4x5mm_P0.65mm_EP3x3mm_ThermalVias
U2004: OPA859xDSG; WSON-8-1EP_2x2mm_P0.5mm_EP0.9x1.6mm

Connections:
+2V5_analog: C2010.1, C2011.1, C2014.1, C2015.1, C2016.1, C2017.1, U2003.3 (VCCI), U2003.4 (PWUP), U2003.6 (VCCO), U2003.11 (VCCO), U2004.7 (V+), U2004.8 (~PD); also elsewhere on the board
-2V5_analog: C2008.1, C2009.1, C2012.1, C2013.1, C2016.2, C2017.2, R2008.1, U2003.2 (ICOM), U2003.7 (OCOM), U2003.10 (OCOM), U2003.15 (ICOM), U2003.17 (ICOM), U2004.5 (V-); also elsewhere on the board
/ADC/ADC_CHB_IN_N: U2003.8 (OPHI); also elsewhere on the board
/ADC/ADC_CHB_IN_P: U2003.9 (OPLO); also elsewhere on the board
/Front End/FE_CHA/PGA_CTL_CLK: U2003.13 (CLCK); also elsewhere on the board
/Front End/FE_CHA/PGA_CTL_DATA: U2003.14 (DATA); also elsewhere on the board
/Front End/FE_CHB/FE_CTL_AC: R2002.2; also elsewhere on the board
/Front End/FE_CHB/FE_CTL_ATT: R2001.2, R2003.2; also elsewhere on the board
/Front End/FE_CHB/FE_CTL_TERM: D2001.1 (K), K2001.5; also elsewhere on the board
/Front End/FE_CHB/PGA_CTL_LATCH: U2003.12 (LTCH); also elsewhere on the board
/Front End/FE_CHB/PGA_INLO: C2003.1, U2003.16 (INLO); also elsewhere on the board
GND: C2001.2, C2002.1, C2003.2, C2006.1, C2007.2, C2008.2, C2009.2, C2010.2, C2011.2, C2012.2, C2013.2, C2014.2, C2015.2, D2001.2 (A), J2001.2 (Ext), J2002.1 (Shield), J2003.1 (Shield), K2001.2, K2001.8, R2003.1, U2001.2 (GND), U2001.3 (NC), U2002.2, U2004.4 (+); also elsewhere on the board
unnamed: C2005.2, J2001.1 (In), JP2001.1 (A), U2002.4
unnamed: C2005.1, JP2001.3 (B), R2006.2, U2002.3
unnamed: JP2001.2 (C), K2001.4
unnamed: R2002.1, U2002.1
unnamed: R2005.2, R2006.1, R2007.2
unnamed: R2005.1, U2001.4 (COM)
unnamed: C2001.1, R2001.1, U2001.6 (IN)
unnamed: C2004.1, R2004.2, R2007.1, U2001.1 (NO), U2004.3 (-)
unnamed: U2003.1 (INHI), U2004.6
unnamed: C2007.1, U2003.5 (VOCM)
unnamed: C2006.2, R2008.2, U2004.9 (EP)
unnamed: C2004.2, R2004.1, U2004.1 (FB)
Vpp_analog: C2002.2, U2001.5 (V+); also elsewhere on the board

Parts of its further copies:
C1001, C1002, C1003, C1006, C1008, C1010, C1012, C1014, C1016, C1017: 100n; C_0603_1608Metric; Part CL10B104KB8NFN
C1004: 10p; C_0402_1005Metric
C1005: 10n; C_0805_2012Metric
C1007, C1013, C1015: 2n; C_0603_1608Metric
C1009, C1011: 1u; C_0805_2012Metric; Part CGA4J2X7R1C105K125AA
D1001: NSR0170HT1G; D_SOD-323; Part NSR0170HT1G
J1001: BNC; BNC_Molex_0731713150; Part 0731713150
J1002: RFShield_Front; Leader SMS-255F; Part SMS-255F+C
J1003: RFShield_Back; SMS-202F; Part SMS-202F+C
JP1001: 50Ohm; J_0603_V
K1001: G6L-1F; Part G6L-1F
R1001, R1003, R1008: 1M; R_0603_1608Metric
R1002: 1k; R_0603_1608Metric
R1004: 1M; R_0402_1005Metric
R1005: 100k/100p; RC_0603_1608Metric
R1006, R1007: 909k/11p; RC_0603_1608Metric
U1001: TS5A63157DCK; SOT-363_SC-70-6_small_cyd
U1002: AQY280S; SOP-4_3.8x4.1mm_P2.54mm
U1003: AD8370; TSSOP-16-1EP_4.4x5mm_P0.65mm_EP3x3mm_ThermalVias
U1004: OPA859xDSG; WSON-8-1EP_2x2mm_P0.5mm_EP0.9x1.6mm

Connections of its further copies:
+2V5_analog: C1010.1, C1011.1, C1014.1, C1015.1, C1016.1, C1017.1, U1003.3 (VCCI), U1003.4 (PWUP), U1003.6 (VCCO), U1003.11 (VCCO), U1004.7 (V+), U1004.8 (~PD); also elsewhere on the board
-2V5_analog: C1008.1, C1009.1, C1012.1, C1013.1, C1016.2, C1017.2, R1008.1, U1003.2 (ICOM), U1003.7 (OCOM), U1003.10 (OCOM), U1003.15 (ICOM), U1003.17 (ICOM), U1004.5 (V-); also elsewhere on the board
/ADC/ADC_CHA_IN_N: U1003.8 (OPHI); also elsewhere on the board
/ADC/ADC_CHA_IN_P: U1003.9 (OPLO); also elsewhere on the board
/Front End/FE_CHA/FE_CTL_AC: R1002.2; also elsewhere on the board
/Front End/FE_CHA/FE_CTL_ATT: R1001.2, R1003.2; also elsewhere on the board
/Front End/FE_CHA/FE_CTL_TERM: D1001.1 (K), K1001.5; also elsewhere on the board
/Front End/FE_CHA/PGA_CTL_CLK: U1003.13 (CLCK); also elsewhere on the board
/Front End/FE_CHA/PGA_CTL_DATA: U1003.14 (DATA); also elsewhere on the board
/Front End/FE_CHA/PGA_CTL_LATCH: U1003.12 (LTCH); also elsewhere on the board
/Front End/FE_CHA/PGA_INLO: C1003.1, U1003.16 (INLO); also elsewhere on the board
GND: C1001.2, C1002.1, C1003.2, C1006.1, C1007.2, C1008.2, C1009.2, C1010.2, C1011.2, C1012.2, C1013.2, C1014.2, C1015.2, D1001.2 (A), J1001.2 (Ext), J1002.1 (Shield), J1003.1 (Shield), K1001.2, K1001.8, R1003.1, U1001.2 (GND), U1001.3 (NC), U1002.2, U1004.4 (+); also elsewhere on the board
unnamed: C1005.2, J1001.1 (In), JP1001.1 (A), U1002.4
unnamed: C1005.1, JP1001.3 (B), R1006.2, U1002.3
unnamed: JP1001.2 (C), K1001.4
unnamed: R1002.1, U1002.1
unnamed: R1005.2, R1006.1, R1007.2
unnamed: R1005.1, U1001.4 (COM)
unnamed: C1001.1, R1001.1, U1001.6 (IN)
unnamed: C1004.1, R1004.2, R1007.1, U1001.1 (NO), U1004.3 (-)
unnamed: U1003.1 (INHI), U1004.6
unnamed: C1007.1, U1003.5 (VOCM)
unnamed: C1006.2, R1008.2, U1004.9 (EP)
unnamed: C1004.2, R1004.1, U1004.1 (FB)
Vpp_analog: C1002.2, U1001.5 (V+); also elsewhere on the board

Notes on the sheet:
Ideally: 101k//99p but 99p is not available
Populate 1-2 or 2-3 with 50Ohm termination resistor depending on whether you like the termination to be AC- or DC-coupled.

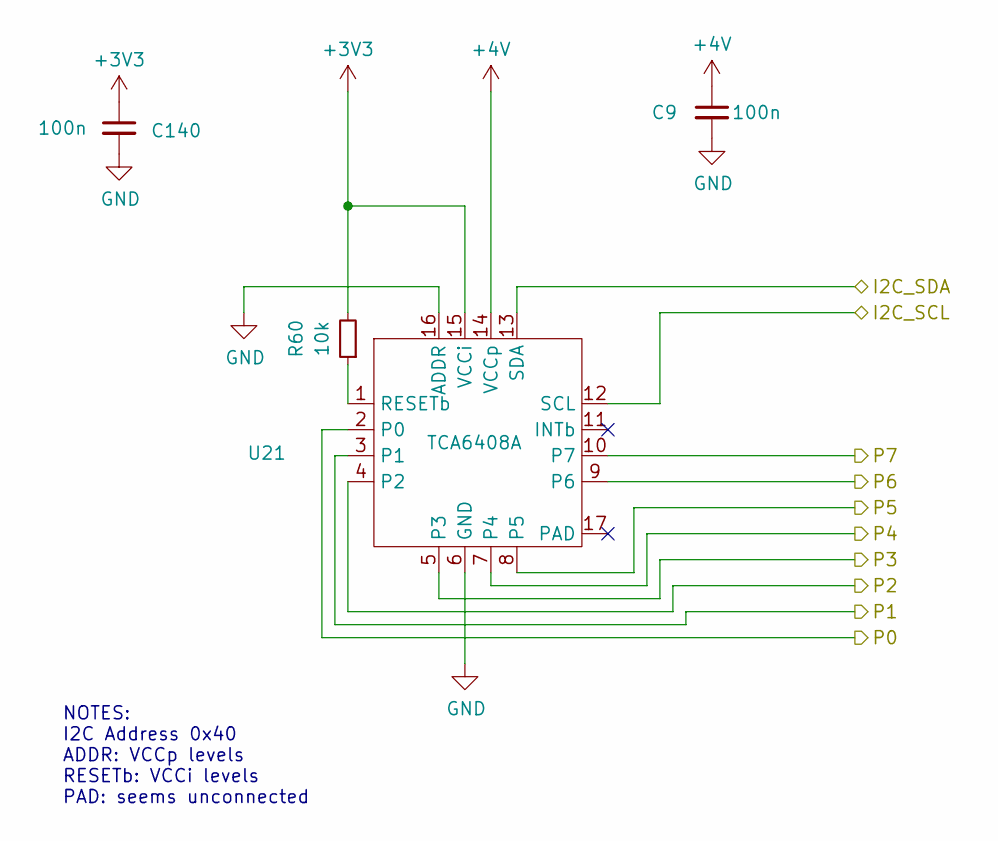
[picture p11: schematic fe_ctl.kicad_sch, IO Extender / Level Shifter]

Parts:
C9, C140: 100n; C_0603_1608Metric; Part CL10B104KB8NFN
R60: 10k; R_0603_1608Metric; Part RMCF0603FT10K0
U21: TCA6408A; QFN-16-1EP_3x3mm_P0.5mm_EP1.45x1.45mm_ThermalVias; Part TCA6408ARGTR

Connections:
+3V3: C140.1, R60.2, U21.15 (VCCi); also elsewhere on the board
+4V: C9.1, U21.14 (VCCp); also elsewhere on the board
/Front End/FE_CHA/FE_CTL_AC: U21.8 (P5); also elsewhere on the board
/Front End/FE_CHA/FE_CTL_ATT: U21.7 (P4); also elsewhere on the board
/Front End/FE_CHB/FE_CTL_AC: U21.5 (P3); also elsewhere on the board
/Front End/FE_CHB/FE_CTL_ATT: U21.4 (P2); also elsewhere on the board
/Front End/fe_ctl/P0: U21.2 (P0); also elsewhere on the board
/Front End/fe_ctl/P1: U21.3 (P1); also elsewhere on the board
/Front End/fe_ctl/P6: U21.9 (P6); also elsewhere on the board
/Front End/fe_ctl/P7: U21.10 (P7); also elsewhere on the board
GND: C9.2, C140.2, U21.6 (GND), U21.16 (ADDR); also elsewhere on the board
I2C_SCL_3V3: U21.12 (SCL); also elsewhere on the board
I2C_SDA_3V3: U21.13 (SDA); also elsewhere on the board
unnamed: R60.1, U21.1 (RESETb)

Notes on the sheet:
NOTES: I2C Address 0x40 ADDR: VCCp levels RESETb: VCCi levels PAD: seems unconnected

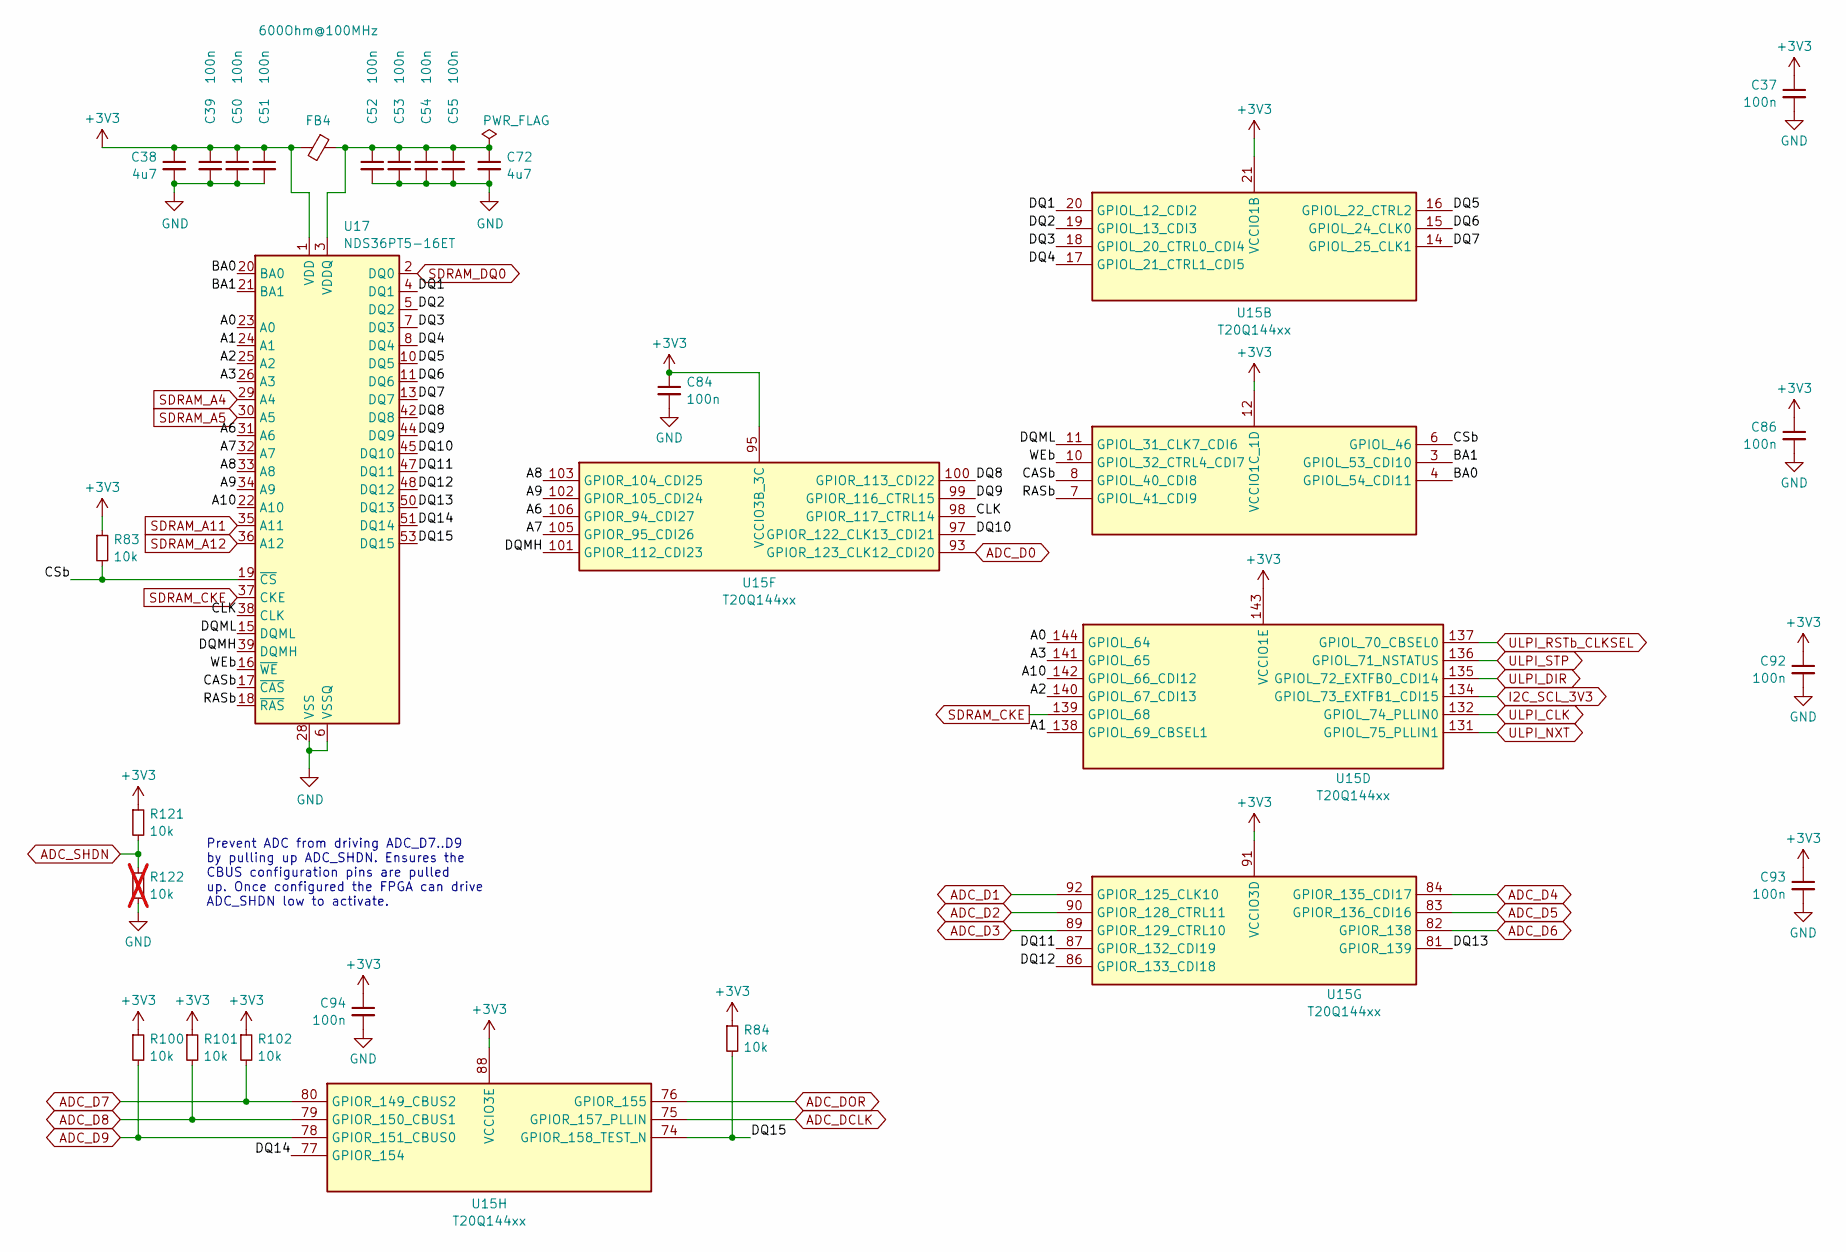
[picture p12: schematic sdram.kicad_sch, FPGA Bank 1, 3; SDRAM]

Parts:
C37, C39, C50, C51, C52, C53, C54, C55, C84, C86, C92, C93, C94: 100n; C_0603_1608Metric; Part CL10B104KB8NFN
C38, C72: 4u7; C_0805_2012Metric; Part 2012X5R1C475K125AC
FB4: 600Ohm@100MHz; L_0603_1608Metric; Part MI0603J601R-10
R83, R84, R100, R101, R102, R121: 10k; R_0603_1608Metric; Part RMCF0603FT10K0
R122: 10k; R_0603_1608Metric; Part RMCF0603FT10K0; not fitted
U15: T20Q144xx; LQFP-144_20x20mm_P0.5mm; Part T20Q144C4
U17: NDS36PT5-16ET; TSOP-II-54_22.2x10.16mm_P0.8mm; Part NDS36PT5-16ET

Connections:
+3V3: C37.1, C38.1, C39.1, C50.1, C51.1, C84.1, C86.1, C92.1, C93.1, C94.1, FB4.2, R83.1, R84.1, R100.1, R101.1, R102.1, R121.1, U15.12 (VCCIO1C_1D), U15.21 (VCCIO1B), U15.88 (VCCIO3E), U15.91 (VCCIO3D), U15.95 (VCCIO3B_3C), U15.143 (VCCIO1E), U17.1 (VDD), U17.14 (VDD), U17.27 (VDD); also elsewhere on the board
/FPGA Trion/sdram/A0: U15.144 (GPIOL_64), U17.23 (A0)
/FPGA Trion/sdram/A1: U15.138 (GPIOL_69_CBSEL1), U17.24 (A1)
/FPGA Trion/sdram/A2: U15.140 (GPIOL_67_CDI13), U17.25 (A2)
/FPGA Trion/sdram/A3: U15.141 (GPIOL_65), U17.26 (A3)
/FPGA Trion/sdram/A6: U15.106 (GPIOR_94_CDI27), U17.31 (A6)
/FPGA Trion/sdram/A7: U15.105 (GPIOR_95_CDI26), U17.32 (A7)
/FPGA Trion/sdram/A8: U15.103 (GPIOR_104_CDI25), U17.33 (A8)
/FPGA Trion/sdram/A9: U15.102 (GPIOR_105_CDI24), U17.34 (A9)
/FPGA Trion/sdram/A10: U15.142 (GPIOL_66_CDI12), U17.22 (A10)
/FPGA Trion/sdram/BA0: U15.4 (GPIOL_54_CDI11), U17.20 (BA0)
/FPGA Trion/sdram/BA1: U15.3 (GPIOL_53_CDI10), U17.21 (BA1)
/FPGA Trion/sdram/CASb: U15.8 (GPIOL_40_CDI8), U17.17 (~CAS)
/FPGA Trion/sdram/CLK: U15.98 (GPIOR_117_CTRL14), U17.38 (CLK)
/FPGA Trion/sdram/CSb: R83.2, U15.6 (GPIOL_46), U17.19 (~CS)
/FPGA Trion/sdram/DQ1: U15.20 (GPIOL_12_CDI2), U17.4 (DQ1)
/FPGA Trion/sdram/DQ2: U15.19 (GPIOL_13_CDI3), U17.5 (DQ2)
/FPGA Trion/sdram/DQ3: U15.18 (GPIOL_20_CTRL0_CDI4), U17.7 (DQ3)
/FPGA Trion/sdram/DQ4: U15.17 (GPIOL_21_CTRL1_CDI5), U17.8 (DQ4)
/FPGA Trion/sdram/DQ5: U15.16 (GPIOL_22_CTRL2), U17.10 (DQ5)
/FPGA Trion/sdram/DQ6: U15.15 (GPIOL_24_CLK0), U17.11 (DQ6)
/FPGA Trion/sdram/DQ7: U15.14 (GPIOL_25_CLK1), U17.13 (DQ7)
/FPGA Trion/sdram/DQ8: U15.100 (GPIOR_113_CDI22), U17.42 (DQ8)
/FPGA Trion/sdram/DQ9: U15.99 (GPIOR_116_CTRL15), U17.44 (DQ9)
/FPGA Trion/sdram/DQ10: U15.97 (GPIOR_122_CLK13_CDI21), U17.45 (DQ10)
/FPGA Trion/sdram/DQ11: U15.87 (GPIOR_132_CDI19), U17.47 (DQ11)
/FPGA Trion/sdram/DQ12: U15.86 (GPIOR_133_CDI18), U17.48 (DQ12)
/FPGA Trion/sdram/DQ13: U15.81 (GPIOR_139), U17.50 (DQ13)
/FPGA Trion/sdram/DQ14: U15.77 (GPIOR_154), U17.51 (DQ14)
/FPGA Trion/sdram/DQ15: R84.2, U15.74 (GPIOR_158_TEST_N), U17.53 (DQ15)
/FPGA Trion/sdram/DQMH: U15.101 (GPIOR_112_CDI23), U17.39 (DQMH)
/FPGA Trion/sdram/DQML: U15.11 (GPIOL_31_CLK7_CDI6), U17.15 (DQML)
/FPGA Trion/sdram/RASb: U15.7 (GPIOL_41_CDI9), U17.18 (~RAS)
/FPGA Trion/sdram/WEb: U15.10 (GPIOL_32_CTRL4_CDI7), U17.16 (~WE)
ADC_D0: U15.93 (GPIOR_123_CLK12_CDI20); also elsewhere on the board
ADC_D1: U15.92 (GPIOR_125_CLK10); also elsewhere on the board
ADC_D2: U15.90 (GPIOR_128_CTRL11); also elsewhere on the board
ADC_D3: U15.89 (GPIOR_129_CTRL10); also elsewhere on the board
ADC_D4: U15.84 (GPIOR_135_CDI17); also elsewhere on the board
ADC_D5: U15.83 (GPIOR_136_CDI16); also elsewhere on the board
ADC_D6: U15.82 (GPIOR_138); also elsewhere on the board
ADC_D7: R102.2, U15.80 (GPIOR_149_CBUS2); also elsewhere on the board
ADC_D8: R101.2, U15.79 (GPIOR_150_CBUS1); also elsewhere on the board
ADC_D9: R100.2, U15.78 (GPIOR_151_CBUS0); also elsewhere on the board
ADC_DCLK: U15.75 (GPIOR_157_PLLIN); also elsewhere on the board
ADC_DOR: U15.76 (GPIOR_155); also elsewhere on the board
ADC_SHDN: R121.2, R122.1; also elsewhere on the board
GND: C37.2, C38.2, C39.2, C50.2, C51.2, C52.2, C53.2, C54.2, C55.2, C72.2, C84.2, C86.2, C92.2, C93.2, C94.2, R122.2, U17.6 (VSSQ), U17.12 (VSSQ), U17.28 (VSS), U17.41 (VSS), U17.46 (VSSQ), U17.52 (VSSQ), U17.54 (VSS); also elsewhere on the board
I2C_SCL_3V3: U15.134 (GPIOL_73_EXTFB1_CDI15); also elsewhere on the board
unnamed: C52.1, C53.1, C54.1, C55.1, C72.1, FB4.1, U17.3 (VDDQ), U17.9 (VDDQ), U17.43 (VDDQ), U17.49 (VDDQ)
SDRAM_A4: U17.29 (A4); also elsewhere on the board
SDRAM_A5: U17.30 (A5); also elsewhere on the board
SDRAM_A11: U17.35 (A11); also elsewhere on the board
SDRAM_A12: U17.36 (A12); also elsewhere on the board
SDRAM_CKE: U15.139 (GPIOL_68), U17.37 (CKE)
SDRAM_DQ0: U17.2 (DQ0); also elsewhere on the board
ULPI_CLK: U15.132 (GPIOL_74_PLLIN0); also elsewhere on the board
ULPI_DIR: U15.135 (GPIOL_72_EXTFB0_CDI14); also elsewhere on the board
ULPI_NXT: U15.131 (GPIOL_75_PLLIN1); also elsewhere on the board
ULPI_RSTb_CLKSEL: U15.137 (GPIOL_70_CBSEL0); also elsewhere on the board
ULPI_STP: U15.136 (GPIOL_71_NSTATUS); also elsewhere on the board

Notes on the sheet:
Prevent ADC from driving ADC_D7..D9 by pulling up ADC_SHDN. Ensures the CBUS configuration pins are pulled up. Once configured the FPGA can drive ADC_SHDN low to activate.

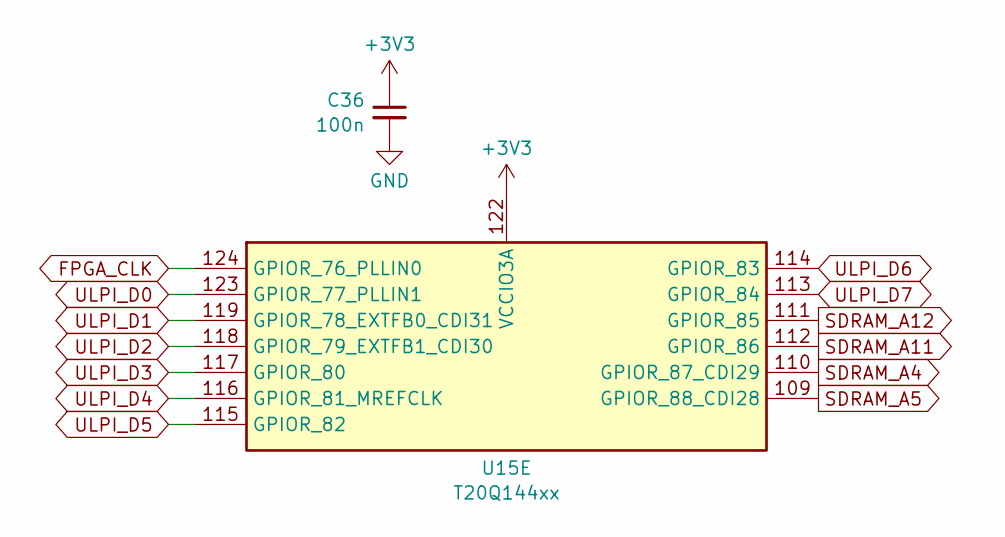
[picture p13: schematic bank_3a.kicad_sch, FPGA Bank 3a]

Parts:
C36: 100n; C_0603_1608Metric; Part CL10B104KB8NFN
U15: T20Q144xx; LQFP-144_20x20mm_P0.5mm; Part T20Q144C4

Connections:
+3V3: C36.1, U15.122 (VCCIO3A); also elsewhere on the board
FPGA_CLK: U15.124 (GPIOR_76_PLLIN0); also elsewhere on the board
GND: C36.2; also elsewhere on the board
SDRAM_A4: U15.110 (GPIOR_87_CDI29); also elsewhere on the board
SDRAM_A5: U15.109 (GPIOR_88_CDI28); also elsewhere on the board
SDRAM_A11: U15.112 (GPIOR_86); also elsewhere on the board
SDRAM_A12: U15.111 (GPIOR_85); also elsewhere on the board
ULPI_D0: U15.123 (GPIOR_77_PLLIN1); also elsewhere on the board
ULPI_D1: U15.119 (GPIOR_78_EXTFB0_CDI31); also elsewhere on the board
ULPI_D2: U15.118 (GPIOR_79_EXTFB1_CDI30); also elsewhere on the board
ULPI_D3: U15.117 (GPIOR_80); also elsewhere on the board
ULPI_D4: U15.116 (GPIOR_81_MREFCLK); also elsewhere on the board
ULPI_D5: U15.115 (GPIOR_82); also elsewhere on the board
ULPI_D6: U15.114 (GPIOR_83); also elsewhere on the board
ULPI_D7: U15.113 (GPIOR_84); also elsewhere on the board

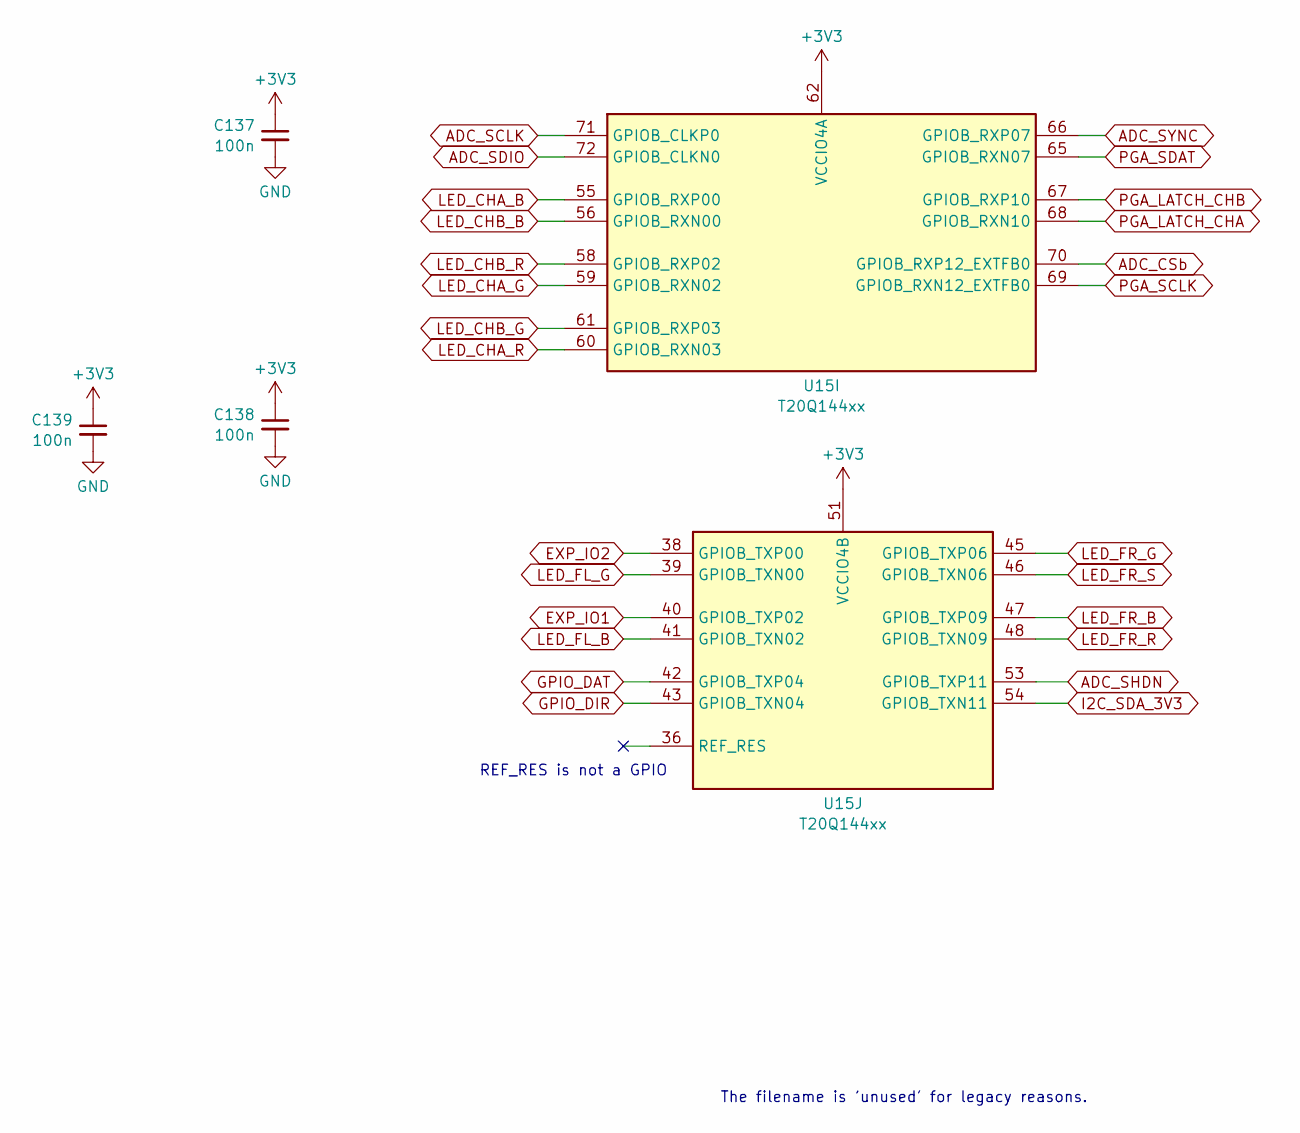
[picture p14: schematic bank_4a_4b.kicad_sch, FPGA Bank 4]

Parts:
C137, C138, C139: 100n; C_0603_1608Metric; Part CL10B104KB8NFN
U15: T20Q144xx; LQFP-144_20x20mm_P0.5mm; Part T20Q144C4

Connections:
+3V3: C137.1, C138.1, C139.1, U15.51 (VCCIO4B), U15.52 (VCCIO4B), U15.62 (VCCIO4A), U15.63 (VCCIO4A); also elsewhere on the board
ADC_CSb: U15.70 (GPIOB_RXP12_EXTFB0); also elsewhere on the board
ADC_SCLK: U15.71 (GPIOB_CLKP0); also elsewhere on the board
ADC_SDIO: U15.72 (GPIOB_CLKN0); also elsewhere on the board
ADC_SHDN: U15.53 (GPIOB_TXP11); also elsewhere on the board
ADC_SYNC: U15.66 (GPIOB_RXP07); also elsewhere on the board
EXP_IO1: U15.40 (GPIOB_TXP02); also elsewhere on the board
EXP_IO2: U15.38 (GPIOB_TXP00); also elsewhere on the board
GND: C137.2, C138.2, C139.2; also elsewhere on the board
GPIO_DAT: U15.42 (GPIOB_TXP04); also elsewhere on the board
GPIO_DIR: U15.43 (GPIOB_TXN04); also elsewhere on the board
I2C_SDA_3V3: U15.54 (GPIOB_TXN11); also elsewhere on the board
LED_CHA_B: U15.55 (GPIOB_RXP00); also elsewhere on the board
LED_CHA_G: U15.59 (GPIOB_RXN02); also elsewhere on the board
LED_CHA_R: U15.60 (GPIOB_RXN03); also elsewhere on the board
LED_CHB_B: U15.56 (GPIOB_RXN00); also elsewhere on the board
LED_CHB_G: U15.61 (GPIOB_RXP03); also elsewhere on the board
LED_CHB_R: U15.58 (GPIOB_RXP02); also elsewhere on the board
LED_FL_B: U15.41 (GPIOB_TXN02); also elsewhere on the board
LED_FL_G: U15.39 (GPIOB_TXN00); also elsewhere on the board
LED_FR_B: U15.47 (GPIOB_TXP09); also elsewhere on the board
LED_FR_G: U15.45 (GPIOB_TXP06); also elsewhere on the board
LED_FR_R: U15.48 (GPIOB_TXN09); also elsewhere on the board
LED_FR_S: U15.46 (GPIOB_TXN06); also elsewhere on the board
PGA_LATCH_CHA: U15.68 (GPIOB_RXN10); also elsewhere on the board
PGA_LATCH_CHB: U15.67 (GPIOB_RXP10); also elsewhere on the board
PGA_SCLK: U15.69 (GPIOB_RXN12_EXTFB0); also elsewhere on the board
PGA_SDAT: U15.65 (GPIOB_RXN07); also elsewhere on the board

Notes on the sheet:
The filename is 'unused' for legacy reasons.
REF_RES is not a GPIO
