till-s/kicad-usbadc-a7m195xx/hw/usbadc.kicad_pcb

## KiCad design hw/usbadc.kicad_pcb (continued)

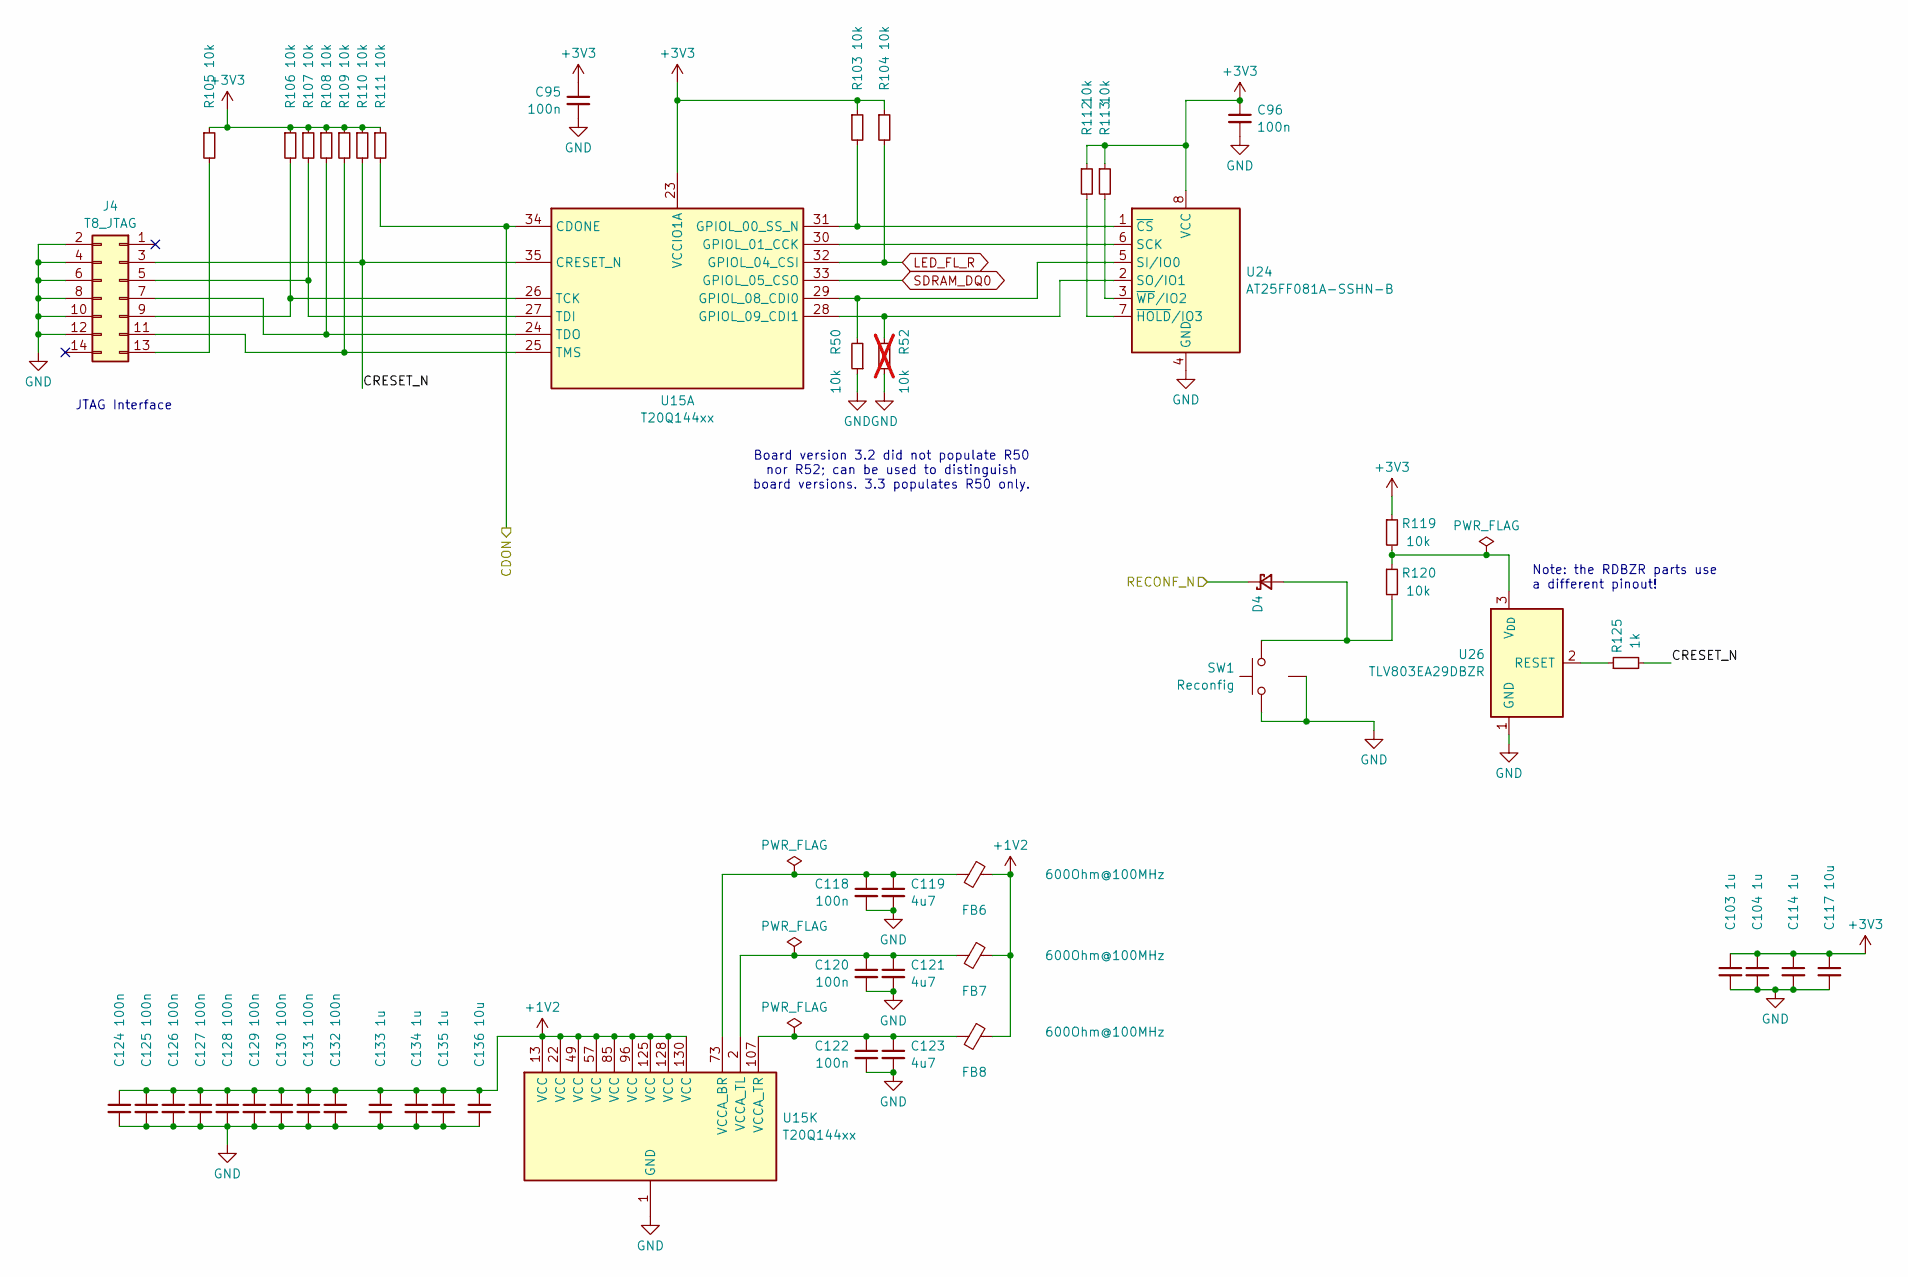
[picture p15: schematic bank_1a_cfg.kicad_sch, FPGA Bank 0: Configuration, SPI Flash, JTAG]

Parts:
C95, C96, C118, C120, C122, C124, C125, C126, C127, C128, C129, C130, C131, C132: 100n; C_0603_1608Metric; Part CL10B104KB8NFN
C103, C104, C114, C133, C134, C135: 1u; C_0805_2012Metric; Part CGA4J2X7R1C105K125AA
C117, C136: 10u; C_1206_3216Metric; Part CL31A106KPHNNNE
C119, C121, C123: 4u7; C_0805_2012Metric; Part 2012X5R1C475K125AC
D4: NSR0170HT1G; D_SOD-323; Part NSR0170HT1G
FB6, FB7, FB8: 600Ohm@100MHz; L_0603_1608Metric; Part MI0603J601R-10
J4: T8_JTAG; PinHeader_2x07_P2.00mm_Vertical; Part 2PH2-14-UA
R50, R103, R104, R105, R106, R107, R108, R109, R110, R111, R112, R113, R119, R120: 10k; R_0603_1608Metric; Part RMCF0603FT10K0
R52: 10k; R_0603_1608Metric; Part RMCF0603FT10K0; not fitted
R125: 1k; R_0603_1608Metric; Part RMCF0603FT1K00
SW1: Reconfig; SW_SPST_PTS810_and_PTS841; Part PTS841GKSMTR
U15: T20Q144xx; LQFP-144_20x20mm_P0.5mm; Part T20Q144C4
U24: AT25FF081A-SSHN-B; SOIC-8_3.9x4.9mm_P1.27mm; Part AT25FF081A-SSHN-B
U26: TLV803EA29DBZR; SOT-23; Part TLV803EA29DBZR

Connections:
+1V2: C124.1, C125.1, C126.1, C127.1, C128.1, C129.1, C130.1, C131.1, C132.1, C133.1, C134.1, C135.1, C136.1, FB6.1, FB7.1, FB8.1, U15.13 (VCC), U15.22 (VCC), U15.49 (VCC), U15.57 (VCC), U15.85 (VCC), U15.96 (VCC), U15.125 (VCC), U15.128 (VCC), U15.130 (VCC); also elsewhere on the board
+3V3: C95.1, C96.1, C103.1, C104.1, C114.1, C117.1, R103.1, R104.1, R105.1, R106.1, R107.1, R108.1, R109.1, R110.1, R111.1, R112.1, R113.1, R119.1, U15.23 (VCCIO1A), U24.8 (VCC); also elsewhere on the board
/FPGA Trion/CDON: R111.2, U15.34 (CDONE); also elsewhere on the board
/FPGA Trion/bank_1a_cfg/CRESET_N: J4.3, R110.2, R125.2, U15.35 (CRESET_N)
/PWR_GOOD: D4.1 (K); also elsewhere on the board
GND: C95.2, C96.2, C103.2, C104.2, C114.2, C117.2, C118.2, C119.2, C120.2, C121.2, C122.2, C123.2, C124.2, C125.2, C126.2, C127.2, C128.2, C129.2, C130.2, C131.2, C132.2, C133.2, C134.2, C135.2, C136.2, J4.2, J4.4, J4.6, J4.8, J4.10, J4.12, R50.1, R52.1, SW1.1, SW1.3 (Shield), U15.1 (GND), U15.5 (GND), U15.9 (GND), U15.37 (GND), U15.44 (GND), U15.50 (GND), U15.64 (GND), U15.94 (GND), U15.104 (GND), U15.108 (GND), U15.120 (GND), U15.121 (GND), U15.126 (GND), U15.127 (GND), U15.129 (GND), U15.133 (GND), U24.4 (GND), U26.1 (GND); also elsewhere on the board
LED_FL_R: R104.2, U15.32 (GPIOL_04_CSI); also elsewhere on the board
unnamed: D4.2 (A), R120.2, SW1.2
unnamed: J4.5, R107.2, U15.27 (TDI)
unnamed: J4.7, R108.2, U15.24 (TDO)
unnamed: J4.9, R106.2, U15.26 (TCK)
unnamed: J4.11, R109.2, U15.25 (TMS)
unnamed: J4.13, R105.2
unnamed: R103.2, U15.31 (GPIOL_00_SS_N), U24.1 (~CS)
unnamed: U15.30 (GPIOL_01_CCK), U24.6 (SCK)
unnamed: R50.2, U15.29 (GPIOL_08_CDI0), U24.5 (SI/IO0)
unnamed: R52.2, U15.28 (GPIOL_09_CDI1), U24.2 (SO/IO1)
unnamed: C118.1, C119.1, FB6.2, U15.73 (VCCA_BR)
unnamed: C120.1, C121.1, FB7.2, U15.2 (VCCA_TL)
unnamed: C122.1, C123.1, FB8.2, U15.107 (VCCA_TR)
unnamed: R112.2, U24.7 (~HOLD/IO3)
unnamed: R113.2, U24.3 (~WP/IO2)
unnamed: R125.1, U26.2 (RESET)
unnamed: R119.2, R120.1, U26.3 (V_{DD})
SDRAM_DQ0: U15.33 (GPIOL_05_CSO); also elsewhere on the board

Parts of its further copies:
C1001, C1002, C1008, C1010, C1012, C1014, C1016, C1017: 100n; C_0603_1608Metric; Part CL10B104KB8NFN

Connections of its further copies:
+2V5_analog: C1010.1, C1014.1, C1016.1, C1017.1; also elsewhere on the board
-2V5_analog: C1008.1, C1012.1, C1016.2, C1017.2; also elsewhere on the board
GND: C1001.2, C1002.1, C1008.2, C1010.2, C1012.2, C1014.2; also elsewhere on the board
unnamed 220: C1001.1; also elsewhere on the board
Vpp_analog: C1002.2; also elsewhere on the board

Notes on the sheet:
Note: the RDBZR parts use a different pinout!
JTAG Interface
Board version 3.2 did not populate R50 nor R52; can be used to distinguish board versions. 3.3 populates R50 only.

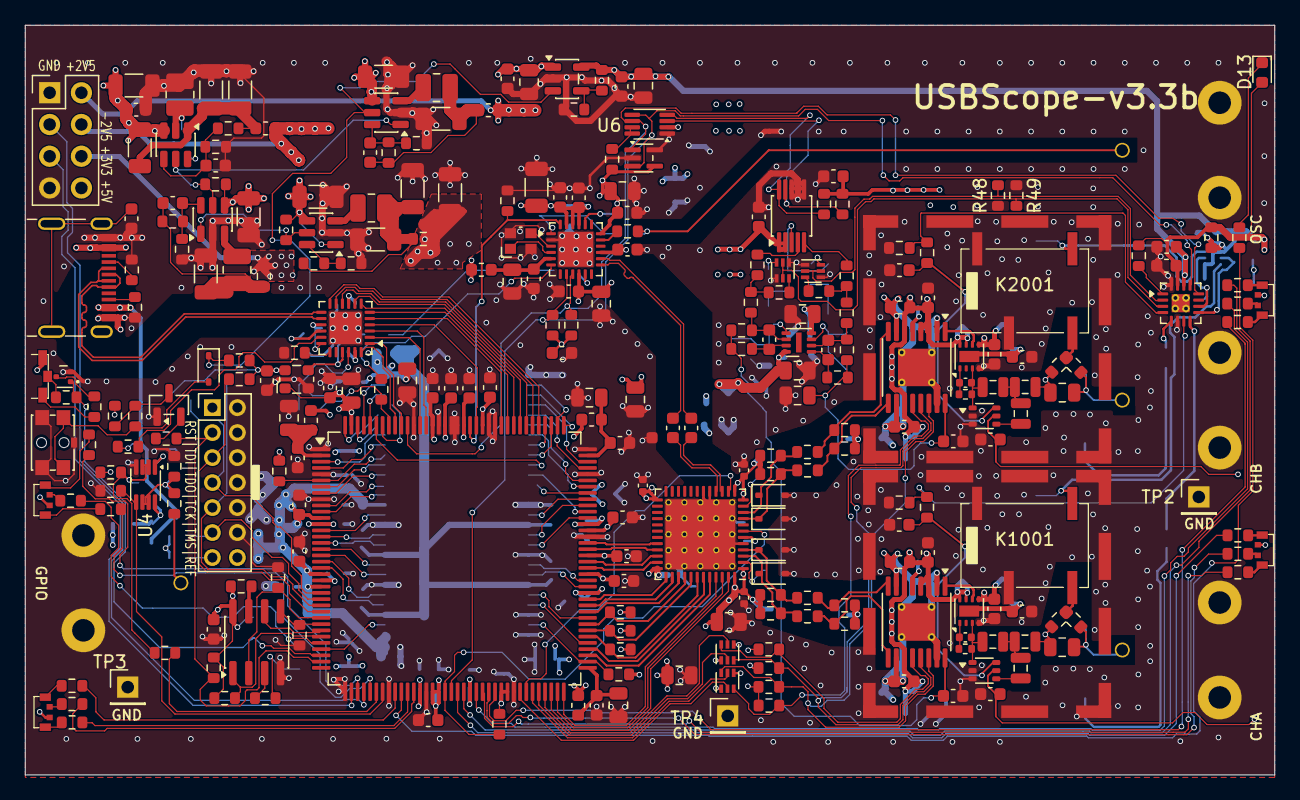
[picture p16: board usbadc.kicad_pcb from above]

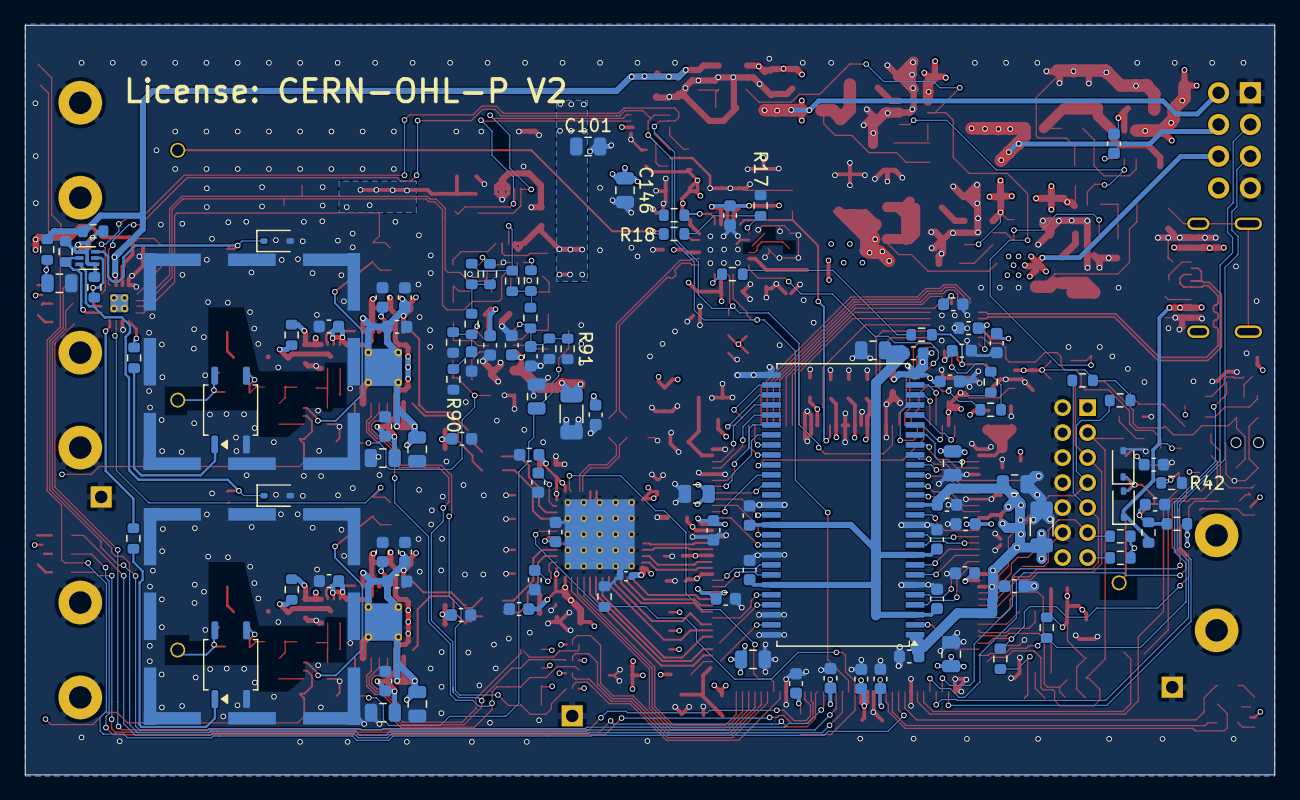
[picture p17: board usbadc.kicad_pcb from below]

Board: 4 copper layers, 100.0 x 60.0 mm, 373 parts (109 on the bottom side), 256 nets.
