till-s/kicad-usbadc-a7m195xx/(commit log)

2023-04-24 renamed files
    [usbadc.kicad_pcb, usbadc.sch]
2023-04-24 upgraded to kicad 6
    [buffer.kicad_sch, buffer.sch, digio.kicad_sch, digio.sch, fpga_xc3s.kicad_sch, fpga_xc3s.sch, max19507.kicad_sch, max19507.sch]
2023-04-24 updates for kicad6
2023-05-11 basic schematic, started layout (placing first components)
    [buffer.kicad_sch, digio.kicad_sch, fpga_xc3s.kicad_sch, max19507.kicad_sch, offset_dac.kicad_sch, pll_clock.kicad_sch, power.kicad_sch, usbadc.kicad_pcb]
2023-05-11 added missing schematic files to git
    [bank14_15.kicad_sch, bank34_35.kicad_sch, bank_0.kicad_sch, fe_ctl.kicad_sch, fpga_a7.kicad_sch, front_end.kicad_sch, unused_pins.kicad_sch, usb_if.kicad_sch]
2023-05-16 WIP (layout)
    [bank14_15.kicad_sch, bank34_35.kicad_sch, digio.kicad_sch, unused_pins.kicad_sch, usbadc.kicad_pcb, usbadc.kicad_sch]
2023-05-18 connected ulpi PHY
    [unused_pins.kicad_sch, usbadc.kicad_pcb, usbadc.kicad_sch]
2023-05-23 WIP - a lot already laid out.
    [bank14_15.kicad_sch, bank_0.kicad_sch, buffer.kicad_sch, digio.kicad_sch, fe_ctl.kicad_sch, fpga_a7.kicad_sch, front_end.kicad_sch, leds.kicad_sch]
2023-05-24 WIP - almost everything except power (converters) connected
    [front_end.kicad_sch, max19507.kicad_sch, pll_clock.kicad_sch, unused_pins.kicad_sch, usbadc.kicad_pcb, usbadc.kicad_sch]
2023-05-25 layout finished (draft)
    [bank14_15.kicad_sch, bank_0.kicad_sch, buffer.kicad_sch, fpga_a7.kicad_sch, leds.kicad_sch, power.kicad_sch, unused_pins.kicad_sch, usbadc.kicad_pcb]
2023-06-03 finished routing; DRC passes (except for 1 hole violation at push-button)
    [bank14_15.kicad_sch, bank_0.kicad_sch, buffer.kicad_sch, fe_ctl.kicad_sch, fpga_a7.kicad_sch, front_end.kicad_sch, leds.kicad_sch, max19507.kicad_sch]
2023-06-05 added 2nd front led; more keepouts around signal lines
    [bank14_15.kicad_sch, bank_0.kicad_sch, fpga_a7.kicad_sch, leds.kicad_sch, power.kicad_sch, unused_pins.kicad_sch, usbadc.kicad_pcb, usbadc.kicad_sch]
2023-06-30 standardized resistor/capacitor values
    [bank14_15.kicad_sch, bank_0.kicad_sch, buffer.kicad_sch, fpga_a7.kicad_sch, leds.kicad_sch, max19507.kicad_sch, pll_clock.kicad_sch, power.kicad_sch]
2023-06-30 removed old firmware (top for spartan device)
2023-07-09 SPI support
2023-07-09 tcl/appCheckAndTouchGitHashFile.tcl: board version is only 8 bits
2023-07-17 ScopeADCTop.vhd: reverted SPI Flash to using BB
2023-07-19 spi-timing.xdc: reworked constraints; in particular multicycle paths
    hold settings were wrong and overconstrained.
2023-07-20 Top: must invert CHA not B
    A has an odd number of inversions in its analog chain whereas
    B has an even number.
2023-07-21 Increase memory to 96k samples. Required ADC FW change.
    ADC: no longer ship trigger position in header.
    96k *just* fits into 35t device.
2023-07-21 Top: increased SPI BB delay for PGA to 200 ticks.
2023-08-05 ScopeADCTop.vhd: added LED register and flicker for trigger LED
2023-08-14 ScopeADCTop.vhd: control trigger led + flicker via software.
    The desired LED state is not identical with the internal state machine's
    HALTED state. Instead, the LED should reflect if the data visible in the
    GUI is valid/updated.
2023-08-18 ScopeADCTop.vhd: ext trigger uses RHS LEDs
2023-08-20 ScopeADCTop.vhd: enabled SPI controller (still have write-errors with BB!)
2023-10-10 buffer.kicad_sch: updated part number of solid-state relay
    [buffer.kicad_sch]
2023-11-12 Use new architecture with ADC DDR unbundled from CommandWrapper
2024-01-04 usbadc-support: SPI flash ID readout fix
2024-03-01 ScopADCTop.vhd: Reconfigured for 10-bit ADC/Memory (reduced depth)
2024-03-03 usbadc-support update
    Use new sample buffer (broken out of MaxAdc)
2024-03-31 ScopeADCTop.vhd: FIX -- had mapped OVR A to OVR B led!
2024-08-07 original copy of trion scope_test project; renamed power.kicad_sch->power_1.kicad_sch
    [bank_1a_cfg.kicad_sch, ethernet.kicad_sch, gps.kicad_sch, led.kicad_sch, power_1.kicad_sch, sdram.kicad_sch, trion-8-test.kicad_pcb, trion-8-test.kicad_sch]
2024-08-07 renamed power.kicad_sch -> power_1.kicad_sch in trion project
    [trion-8-test.kicad_pcb, trion-8-test.kicad_sch]
2024-08-07 cleanup of trion project
    [ethernet.kicad_sch, gps.kicad_sch, led.kicad_sch, sdram.kicad_sch, trion-8-test.kicad_pcb, trion-8-test.kicad_sch, ulpi.kicad_sch, unused.kicad_sch]
2024-08-08 reannotated trion project and moved PCB
    [bank_1a_cfg.kicad_sch, power_1.kicad_sch, sdram.kicad_sch, trion-8-test.kicad_pcb, ulpi.kicad_sch, unused.kicad_sch]
2024-08-09 Added trion top-sheet as sub-sheet to usbadc project
    [bank14_15.kicad_sch, bank34_35.kicad_sch, bank_0.kicad_sch, bank_1a_cfg.kicad_sch, buffer.kicad_sch, fe_ctl.kicad_sch, fpga_a7.kicad_sch, front_end.kicad_sch]
2024-08-10 merged trion-8 PCB
    [bank_1a_cfg.kicad_sch, power_1.kicad_sch, sdram.kicad_sch, trion-8-test.kicad_sch, ulpi.kicad_sch, unused.kicad_sch, usbadc.kicad_pcb]
2024-08-10 removed unused_pins.kicad_sch
    [bank_1a_cfg.kicad_sch, power_1.kicad_sch, sdram.kicad_sch, trion-8-test.kicad_sch, ulpi.kicad_sch, unused.kicad_sch, unused_pins.kicad_sch, usbadc.kicad_pcb]
2024-08-10 Removed ARTIX FPGA
    [bank14_15.kicad_sch, bank34_35.kicad_sch, bank_0.kicad_sch, fpga_a7.kicad_sch, usbadc.kicad_pcb, usbadc.kicad_sch]
2024-08-10 removed THS4255
    [max19507.kicad_sch, usbadc.kicad_pcb]
2024-08-11 rewired 1V8_analog to +2V5_analog
    [fe_ctl.kicad_sch, front_end.kicad_sch, max19507.kicad_sch, offset_dac.kicad_sch, power.kicad_sch, usbadc.kicad_pcb]
2024-08-17 moved trion into place; going to 'hide' footprint reference designators...
    [leds.kicad_sch, max19507.kicad_sch, pll_clock.kicad_sch, power.kicad_sch, sdram.kicad_sch, usb_if.kicad_sch, usbadc.kicad_pcb, usbadc.kicad_sch]
2024-08-20 layout almost complete with UPLI on the RHS => NO CLOCK INPUT
    Have to rework and move the usb transceiver to the left...
    [bank_1a_cfg.kicad_sch, leds.kicad_sch, max19507.kicad_sch, pll_clock.kicad_sch, power.kicad_sch, sdram.kicad_sch, trion-8-test.kicad_sch, ulpi.kicad_sch]
2024-08-24 renamed Trion subsheets
    [bank_3a.kicad_sch, bank_4a_4b.kicad_sch, trion-fpga.kicad_sch, usbadc.kicad_pcb, usbadc.kicad_sch]
2024-08-24 moved board label to front silk screen
    [usbadc.kicad_pcb]
2024-09-03 WIP; converging
    [bank_1a_cfg.kicad_sch, leds.kicad_sch, max19507.kicad_sch, offset_dac.kicad_sch, trion-fpga.kicad_sch, usbadc.kicad_pcb, usbadc.kicad_sch]
2024-09-03 renumbered references on trion sub-sheets
    Had used numbers > 1000 when merging designs
    [bank_1a_cfg.kicad_sch, bank_3a.kicad_sch, bank_4a_4b.kicad_sch, sdram.kicad_sch, usbadc.kicad_pcb]
2024-09-03 PCB: moved +5V on inner layer away from board edge by .3mm
    [usbadc.kicad_pcb]
2024-09-03 PCB: added a few ground/test-points
    [power.kicad_sch, usbadc.kicad_pcb]
2024-09-03 PCB: cleaned up test points
    (some use too much real-estate on inner Vcc layer)
    [power.kicad_sch, usbadc.kicad_pcb]
2024-11-09 updated some component values
    [leds.kicad_sch, pll_clock.kicad_sch, power.kicad_sch, usbadc.kicad_pcb, usbadc.kicad_sch]
2024-11-24 PGA_SDAT / PGA_LATCH_CHB were swapped in top-sheet
    -> corrected there and swapped at FPGA bank keeps the
    layout unmodified but fixes the labels.
    => still compatible with v3.0 as ordered from JLC
    [bank_4a_4b.kicad_sch, usbadc.kicad_pcb, usbadc.kicad_sch]
2024-12-19 Reduced PGA level translator resistors from 10k to 5k1
    Had erroneously loaded 18k and these didn't work. Even though
    the signals looked OK the gain word was not picked up by the
    device w/o errors. Maybe the fall times were slow and had
    noise components that caused spurious clock edges?
    In any case: with 5k1 it now works...
    [front_end.kicad_sch]
2024-12-25 V3 component modifications
    - SS relay is AQY280S (cheaper than original component; should do it)
    - PGA serial interface translator resistors 10k->5k1
    Had erroneously populated with 18k which did not work (unclear why);
    after dropping to 5k1 it works fine.
    [buffer.kicad_sch]
2024-12-25 updated PCB with new components (PGA pulldowns, SSR)
    [usbadc.kicad_pcb]
2024-12-25 consolidated components to simplify BOM
    (nothing actually changed but the symbols representing identical
    components are now identical -> no more multiple BOM entries for
    the same type of component).
    [buffer.kicad_sch, digio.kicad_sch, max19507.kicad_sch, offset_dac.kicad_sch, pll_clock.kicad_sch, power.kicad_sch, usb_if.kicad_sch, usbadc.kicad_pcb]
2024-12-25 consolidated ferrite beads (use same everywhere)
    [bank_1a_cfg.kicad_sch, pll_clock.kicad_sch, power.kicad_sch, sdram.kicad_sch, usbadc.kicad_pcb]
2024-12-25 consolidated 1n caps -> use 2n everywhere
    [buffer.kicad_sch]
2025-01-18 PCB: udated to HW version 3.2
    3.1 will be abandoned; keep existing LED location + type!
    [usbadc.kicad_pcb]
2025-01-18 Moved LEDs from +5V to 3V3. Removed LED driver FETs.
    NOTE: the 3V3 connection is provisional and needs to be
    reworked along with the redesign of the 5V net.
    The temporary connections exist just to satisfy DRC for now.
    [digio.kicad_sch, leds.kicad_sch, pll_clock.kicad_sch, usbadc.kicad_pcb]
2025-01-18 Connected FEC i2c to 3V3
    This permits omitting the i2c level converted if the DAC is not used.
    [fe_ctl.kicad_sch, front_end.kicad_sch, usbadc.kicad_pcb, usbadc.kicad_sch]
2025-01-18 added pull-downs to ctl-input of analog-switches (U11, U18).
    [buffer.kicad_sch, usbadc.kicad_pcb]
2025-01-18 Replaced 5V power switch by LDO.
    Unregulated 5V introduced a LOT of noise into the FE.
    [fe_ctl.kicad_sch, power.kicad_sch, usbadc.kicad_pcb]
2025-01-18 Added (optional) connection from PLL output 4 to ulpi refclock.
    Could spare the crystal oscillator...
    [max19507.kicad_sch, pll_clock.kicad_sch, usbadc.kicad_pcb, usbadc.kicad_sch]
2025-01-19 added jumperable VDDIO for digital I/O, added reset generator
    [bank_1a_cfg.kicad_sch, digio.kicad_sch, power.kicad_sch, trion-fpga.kicad_sch, usbadc.kicad_sch]
2025-01-19 [hw] added reset generator; removed 5V fill from FE area!
    [fe_ctl.kicad_sch, leds.kicad_sch, usb_if.kicad_sch, usbadc.kicad_pcb, usbadc.kicad_sch]
2025-01-19 [hw]: updated relay part no.
    [buffer.kicad_sch, usbadc.kicad_pcb, usbadc.kicad_sch]
2025-01-20 Modified DAC resistors/range; connect + pull-up ADC SHDN
    [bank_4a_4b.kicad_sch, digio.kicad_sch, max19507.kicad_sch, offset_dac.kicad_sch, power.kicad_sch, sdram.kicad_sch, usbadc.kicad_pcb, usbadc.kicad_sch]
2025-01-23 [hw] increased bypass caps on analog +/- supplies
    Caps behind ferrite beads increased from 100n to 1u.
    [power.kicad_sch, usbadc.kicad_pcb]
2025-01-24 [hw]: changed input AC-coupling cap from 100n->10n
    Does not affect PCB
    [buffer.kicad_sch, usbadc.kicad_pcb]
2025-02-03 renaming, comments, part/vendor and other cosmetics (no pcb change)
    [buffer.kicad_sch, fe_ctl.kicad_sch, offset_dac.kicad_sch, usb_if.kicad_sch, usbadc.kicad_pcb, usbadc.kicad_sch]
2025-02-03 pruned unused files
    [fpga_xc3s.kicad_sch, power_1.kicad_sch, trion-8-test.kicad_pcb]
2025-09-09 Conversion to kicad-8
    [bank_1a_cfg.kicad_sch, bank_3a.kicad_sch, bank_4a_4b.kicad_sch, buffer.kicad_sch, digio.kicad_sch, fe_ctl.kicad_sch, front_end.kicad_sch, leds.kicad_sch]
2025-09-27 Modifications to power-supply: noise improvements
    - DNL C12 (cap between 5V input and -2V5); created a bypass for noise
    coming into 5V. Improved spectrum up to ~200kHz, reducing spurs.
    - Enabled C14 (feedback-zero for -2V5 regulator); reduce spurs (unstabilities?)
    - DNL C145 (1u cap after ferrite bead isolating Vpp_analog.
    - Replaced Vpp_analog isolation FB1 by a 10k resistor (R126)
    The bead FB1 behaves as an 2uH inductor at low freq. The LC filter
    formed by FB1 and decoupling caps is drastically underdamped by the
    weak load (only analog switches) and enhances noise in the 10k-200k
    band (depending on caps; particularly bad if C145 is loaded).
    [buffer.kicad_sch, digio.kicad_sch, power.kicad_sch]
2025-09-27 DAC noise improvements
    - increased C108, C109 from 2n to 100n
    - added C147, C148 (100n) parallel to R25, R35, respectively.
    Recycled pads of second 80k6 resistors for new capacitors
    so that the layout + stencil stay the same.
    Significantly improves noise on 10kHz-100kHz band.
    [offset_dac.kicad_sch, usbadc.kicad_pcb]
2026-01-31 prep-work to move front-end into separate project (for replication)
    [buffer.kicad_sch, offset_dac.kicad_sch, usbadc.kicad_pcb]
2026-01-31 added stripped down pcb file and a pro file for buffer.kicad_sch
    [buffer.kicad_pcb]
2026-01-31 split buffer into sub-pcb buffer.kicad.pcb
    [buffer.kicad_pcb, buffer.kicad_sch]
2026-02-01 removed buffer and 100n DAC output caps
    - prep for updating PCB to remove buffer stuff
    - caps were moved to buffer (close to switch)
    [front_end.kicad_sch, offset_dac.kicad_sch]
2026-02-01 pcb: removed buffers
    [usbadc.kicad_pcb]
2026-02-01 sch: re-added buffer to top-project schematic
    [buffer.kicad_sch, front_end.kicad_sch]
2026-02-01 pcb: removed unconnected rectangle (didn't pass merge_pcb verification)
    was introduced to measure cage position; never connected...
    [usbadc.kicad_pcb]
2026-02-02 top pcb; prep for merging (WIP)
    [usbadc.kicad_pcb]
2026-02-02 [WIP] moved DAC to make space for buffer sub-pcb
    [usbadc.kicad_pcb]
2026-02-02 buffer layout almost complete, PGA in through two cage gaps
    [buffer.kicad_pcb, buffer.kicad_sch]
2026-02-03 buffer edited; ready for merge CHA
    [buffer.kicad_pcb, buffer.kicad_sch, usbadc.kicad_pcb]
2026-02-03 usbadc.kicad_pcb: removed temporarily placed channels
    [usbadc.kicad_pcb]
2026-02-03 buffer.kicad_sch: annotated parent project
    prerequisition for merge
    [buffer.kicad_sch]
2026-02-03 usbadc.kicad_pcb: merged FE_CHA
    [usbadc.kicad_pcb]
2026-02-03 buffer: reannotated and updated pcb for FE_CHB
    [buffer.kicad_pcb, buffer.kicad_sch]
2026-02-03 buffer.kicad_sch: updated reannotation for FE_CHB with reannotate.py
    [buffer.kicad_sch]
2026-02-03 usbadc.kicad_pcb moved FE_CHA 2mm up
    Channels are 20mm wide and need 20mm spacing -> doesn't exactly work,
    we must move the boxes a bit farther apart while keeping the BNCs
    in their original place
    [usbadc.kicad_pcb]
2026-02-03 pcb: merged FE_CHB; WARNING: CHA/CHB swapped in this stage!
    [usbadc.kicad_pcb]
2026-02-04 WIP: intermediate commit (routing)
    will try to update library footprints
    [bank_1a_cfg.kicad_sch, buffer.kicad_sch, fe_ctl.kicad_sch, max19507.kicad_sch, usbadc.kicad_pcb]
2026-02-05 most library footprints updated; VSSOP not found
    [usbadc.kicad_pcb]
2026-02-05 added pll clock in divider from BNC, several pull-resistors
    pull-resistors permit distinguishing board revisions.
    [buffer.kicad_sch, digio.kicad_sch, offset_dac.kicad_sch, pll_clock.kicad_sch, usbadc.kicad_pcb, usbadc.kicad_sch]
2026-03-01 moved board-version resistors to SPI interface
    GPIO driver should always be IN (i.e., driving the fpga); thus
    a pull-resistor at that point is useless.
    [bank_1a_cfg.kicad_sch, digio.kicad_sch, usbadc.kicad_pcb]
2026-03-22 updated parts assignments
    [bank_1a_cfg.kicad_sch, buffer.kicad_sch, digio.kicad_sch, fe_ctl.kicad_sch, front_end.kicad_sch, leds.kicad_sch, max19507.kicad_sch, offset_dac.kicad_sch]
2026-03-29 fixed BOM; added relay drivers
    [bank_1a_cfg.kicad_sch, buffer.kicad_sch, front_end.kicad_sch, offset_dac.kicad_sch, pll_clock.kicad_sch, usbadc.kicad_pcb]
2026-05-14 connected versaclock CLKSEL to ULPI RSTB (share FPGA pin)
    ULPI Rstb is unlikely to be used
    Also: - update of kicad to 9.0 (many library footprints updated)
    - added sheet titles, author
    [bank_1a_cfg.kicad_sch, bank_3a.kicad_sch, bank_4a_4b.kicad_sch, buffer.kicad_sch, digio.kicad_sch, fe_ctl.kicad_sch, front_end.kicad_sch, leds.kicad_sch]
2026-05-15 added 3V relay option (different 0ohm jumpers)
    Also: another kicad updat
    [buffer.kicad_sch, front_end.kicad_sch, leds.kicad_sch, usbadc.kicad_pcb]
2026-05-31 Added licensing information
    [bank_1a_cfg.kicad_sch, bank_3a.kicad_sch, bank_4a_4b.kicad_sch, buffer.kicad_sch, digio.kicad_sch, fe_ctl.kicad_sch, front_end.kicad_sch, leds.kicad_sch]
2026-08-11 added some comments in schematics
    [buffer.kicad_sch, front_end.kicad_sch, max19507.kicad_sch, pll_clock.kicad_sch, sdram.kicad_sch]
2026-08-11 move PDF schematics to superproject
