till-s/kicad-usbadc-a7m195xx/(notices)

Notices in the files:
hw/power.kicad_sch:
Copyright Till Straumann, 2025
License: CERN-OHL-P v2
